ZJUNlict/Mechanics/MOTOR/big wheel/small wheel assembly.SLDASM

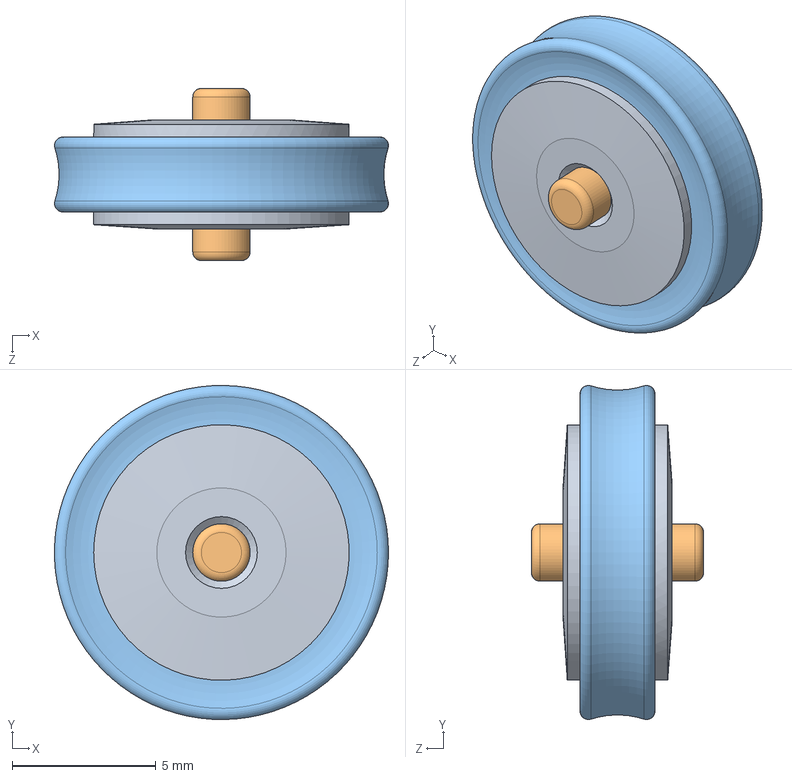
[picture p7: CAD file, 2019-06-18]
MOTOR/big wheel/small wheel assembly.SLDASM
11.6 x 11.6 x 6.00 mm
small wheel
short axle
star_ring
