ZJUNlict/Mechanics/MOTOR/50w_motor_2 assembly.SLDASM

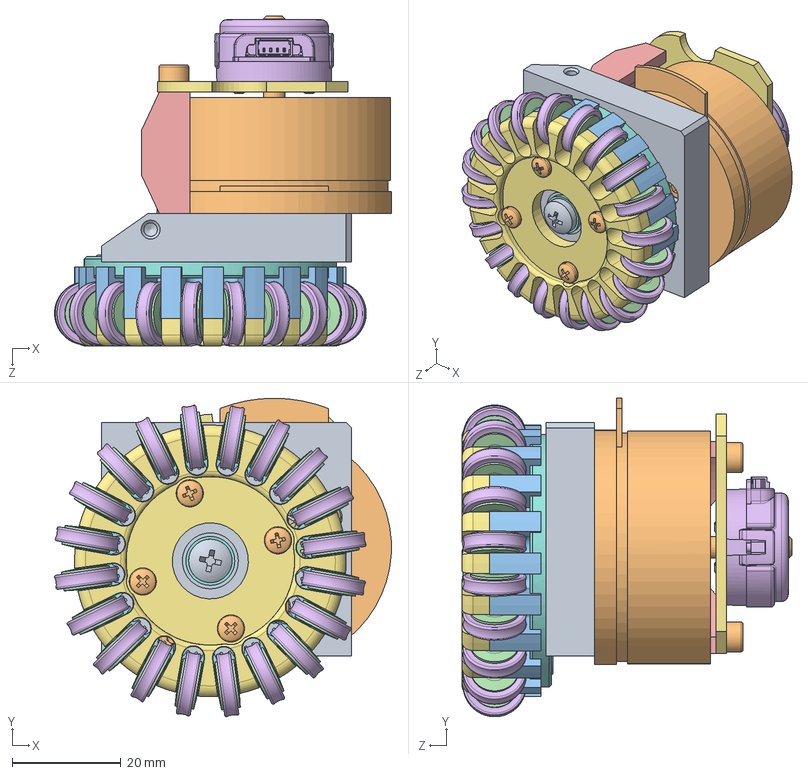
[picture p8: CAD file, 2019-06-18]
MOTOR/50w_motor_2 assembly.SLDASM
62.0 x 58.6 x 60.7 mm
gearbox_2
maxon motor
wheel hub
small wheel x 20
short axle x 20
star_ring x 20
wheel cover
big gear
698ZZ
GB_CROSS_SCREWS_TYPE1 M3X6-6 H TYPE-N x 4
GB_FASTENER_SCREWS_HSHCS M2X6-N x 4
small gear
code holder_1
code cover
code holder_2
GB_FASTENER_WASHER_PWNA 4
GB_CROSS_SCREWS_TYPE1 M4X8-8 H type-N
GB_FASTENER_SCREWS_HSHCS M3X6-N- x 7
