ZJUNlict/Mechanics/KICK SYS/chip shaft assembly.SLDASM

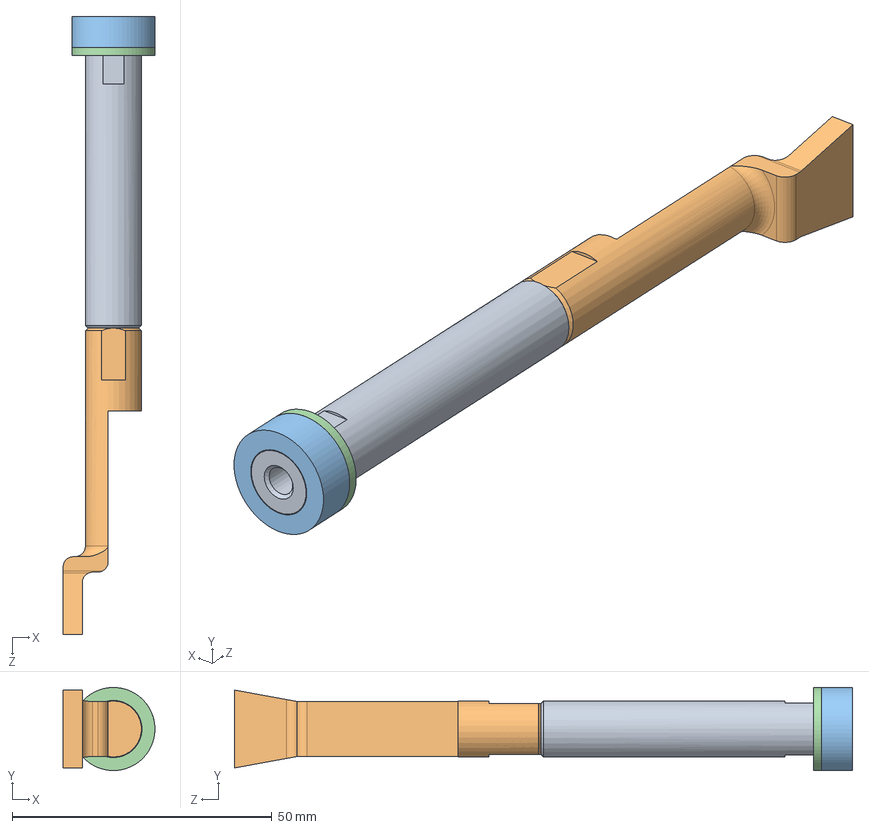
[picture p9: CAD file, 2019-06-18]
KICK SYS/chip shaft assembly.SLDASM
17.7 x 16.0 x 119.0 mm
chip iron core
chip schaft
silicone cushion
buffer block
