ZJUNlict/Mechanics/MOTOR/50w_motor_1 assembly.SLDASM

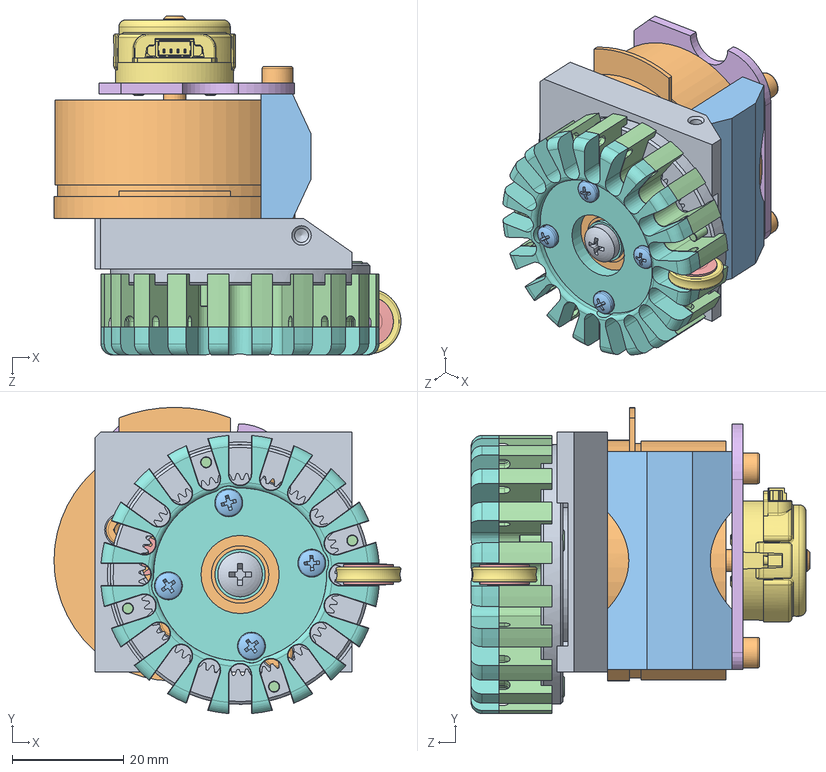
[picture p10: CAD file, 2019-06-18]
MOTOR/50w_motor_1 assembly.SLDASM
62.2 x 54.9 x 60.7 mm
gearbox_1
maxon motor
code holder_1
wheel hub
wheel cover
big gear
698ZZ
GB_CROSS_SCREWS_TYPE1 M3X6-6 H TYPE-N x 4
GB_FASTENER_SCREWS_HSHCS M2X6-N x 4
small gear
code holder_2
code cover
GB_FASTENER_WASHER_PWNA 4
GB_CROSS_SCREWS_TYPE1 M4X8-8 H type-N
GB_FASTENER_SCREWS_HSHCS M3X6-N- x 7
