ZJUNlict/Mechanics/KICK SYS/flat shaft assembly.SLDASM

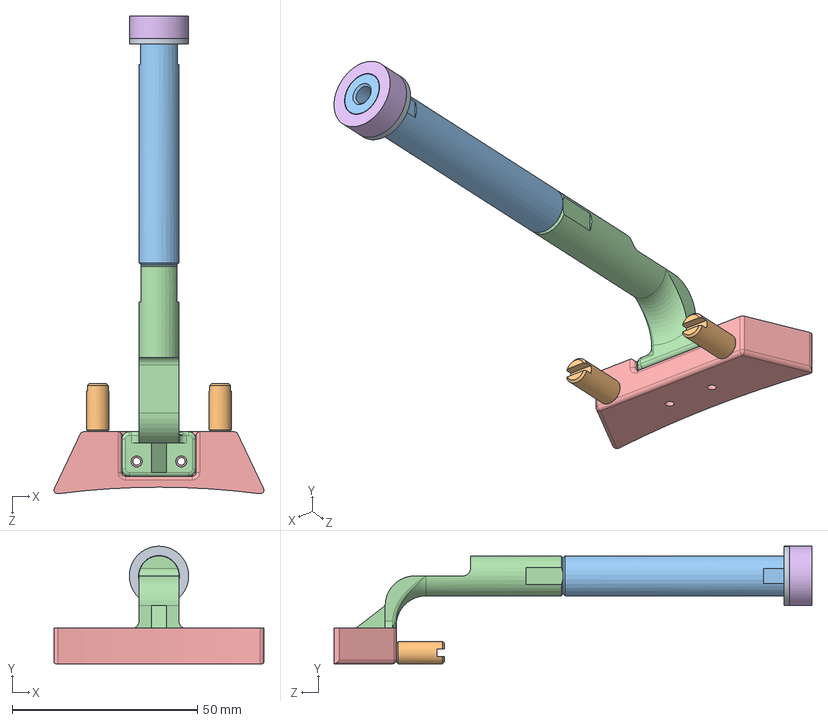
[picture p11: CAD file, 2019-06-18]
KICK SYS/flat shaft assembly.SLDASM
56.6 x 31.7 x 128.7 mm
buffer block
flat guide shaft x 2
flat iron core
flat shaft
flat shove
silicone cushion
