ZJUNlict/Mechanics/BASE/BASE.SLDASM

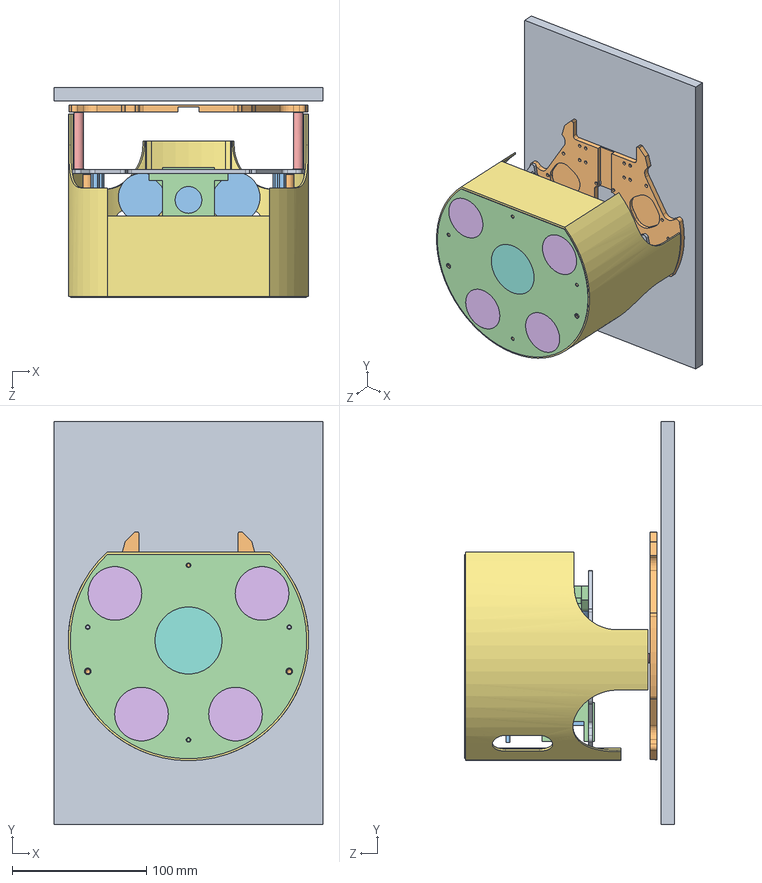
[picture p12: CAD file, 2019-06-18]
BASE/BASE.SLDASM
200.0 x 300.0 x 156.0 mm
baseplate_2018
carpet
circuits
colorcode
downstrut x 2
idcolor x 4
teamcolor
upperplate_2018
upperstrut x 2
battery
batteryholder
