ZJUNlict/Mechanics/MOTOR/big wheel/big wheel assembly.SLDASM

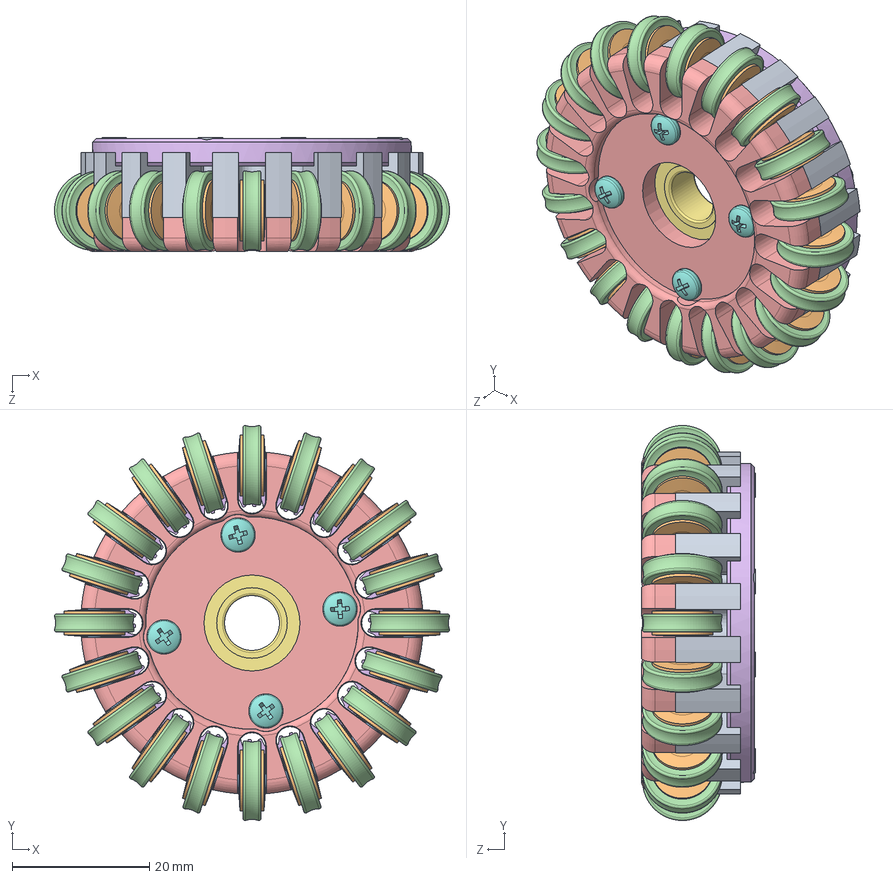
[picture p13: CAD file, 2019-06-18]
MOTOR/big wheel/big wheel assembly.SLDASM
57.6 x 57.6 x 16.7 mm
wheel hub
small wheel x 20
short axle x 20
star_ring x 20
wheel cover
big gear
698ZZ
GB_CROSS_SCREWS_TYPE1 M3X6-6 H TYPE-N x 4
GB_FASTENER_SCREWS_HSHCS M2X6-N x 4
