ZJUNlict/Mechanics/KICK SYS/kick system.SLDASM

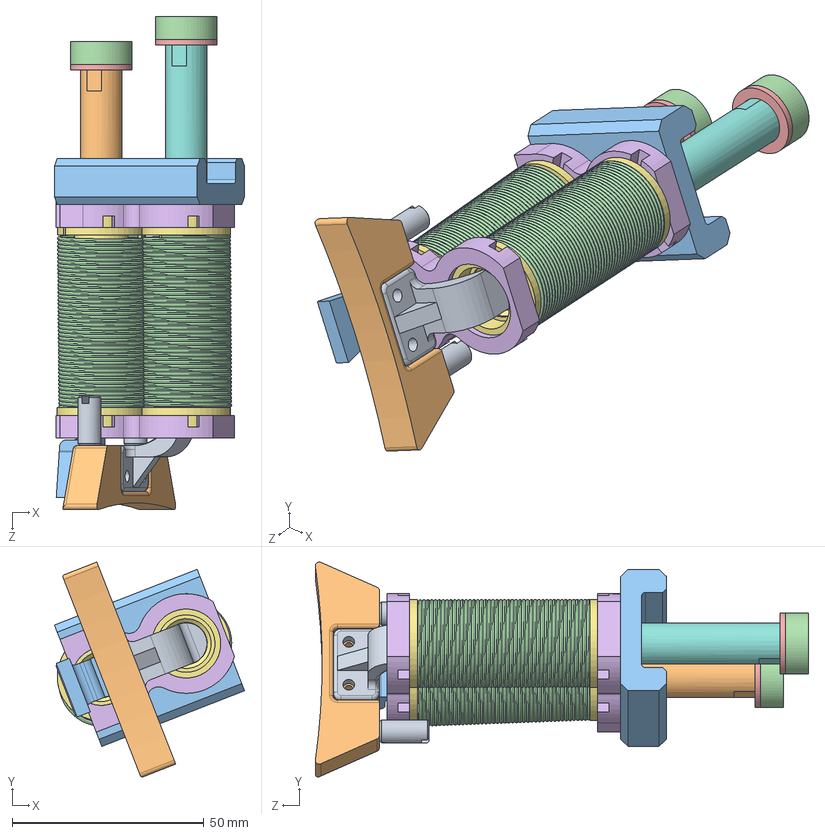
[picture p14: CAD file, 2019-06-18]
KICK SYS/kick system.SLDASM
49.6 x 56.1 x 128.7 mm
chip iron core
chip schaft
silicone cushion x 2
buffer block x 2
coil shelf x 2
flat coil x 2
flat guide shaft x 2
flat iron core
flat shaft
flat shove
limit block
varnished wire x 2
