ZJUNlict/Mechanics/MOUTH/MOUTH_CAN.SLDASM

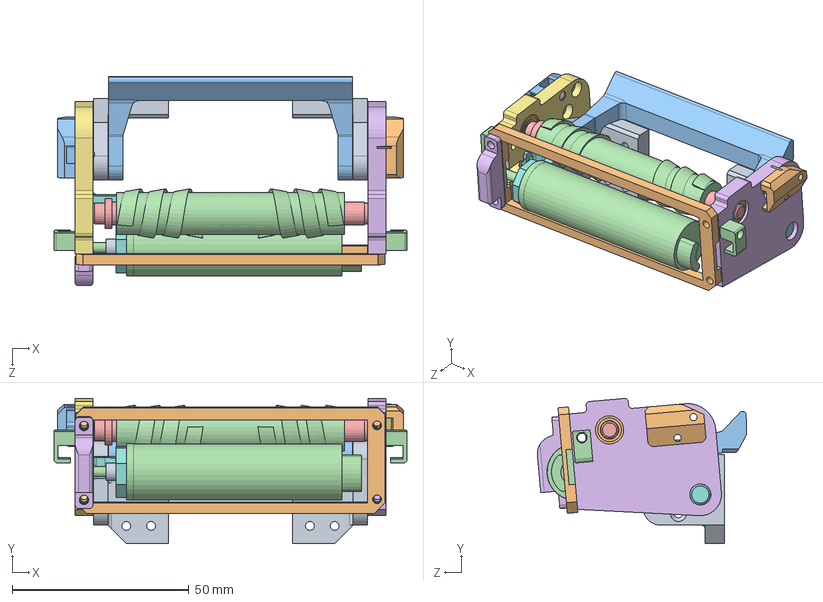
[picture p15: CAD file, 2019-06-18]
MOUTH/MOUTH_CAN.SLDASM
100.0 x 41.1 x 59.3 mm
flat guide block_1
carbon shelf
chip spindle x 2
dribble motor
dribble rod
dribble shelf_1
dribble shelf_2
dribble spindle x 2
flat guide block_2
IR block1
IR block2
IR constraint x 2
IR emitter
IR protector
IR receiver
motor connector
motor sleeve
MR105ZZ x 2
chip sholve_45
silicone tube
