ZJUNlict/Mechanics/MOUTH/MR84ZZ.SLDASM

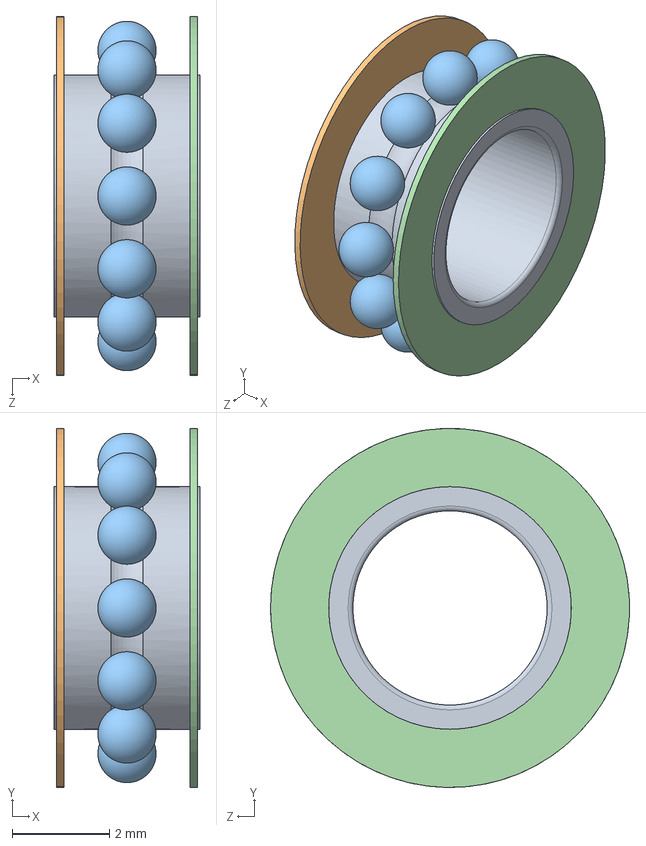
[picture p16: CAD file, 2019-06-18]
MOUTH/MR84ZZ.SLDASM
3.00 x 7.40 x 7.40 mm
_MR84ZZ Inner Ring
_MR84ZZ Shield1
_MR84ZZ Ball x 12
_MR84ZZ Shield2
