ZJUNlict/Mechanics/BASE/carpet.SLDPRT

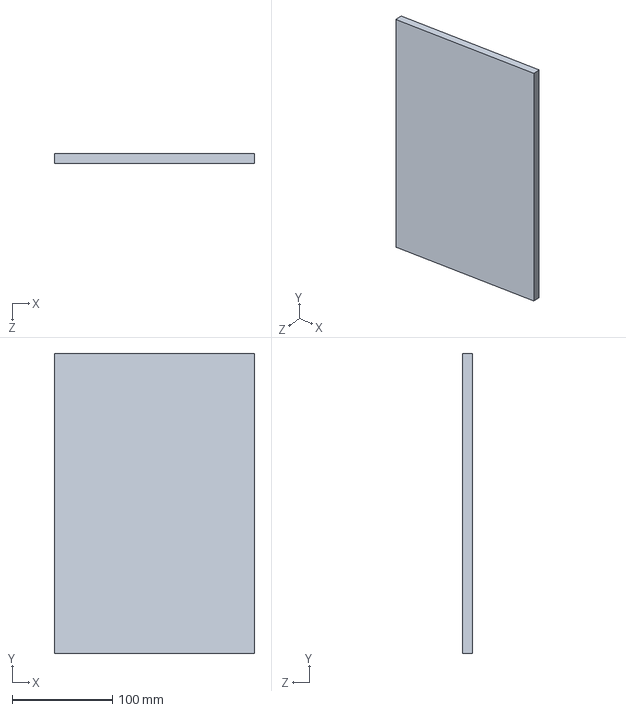
[picture p17: CAD file, 2019-06-19]
BASE/carpet.SLDPRT
200.0 x 300.0 x 10.0 mm
