ZJUNlict/Mechanics/KICK SYS/coil shelf.SLDPRT

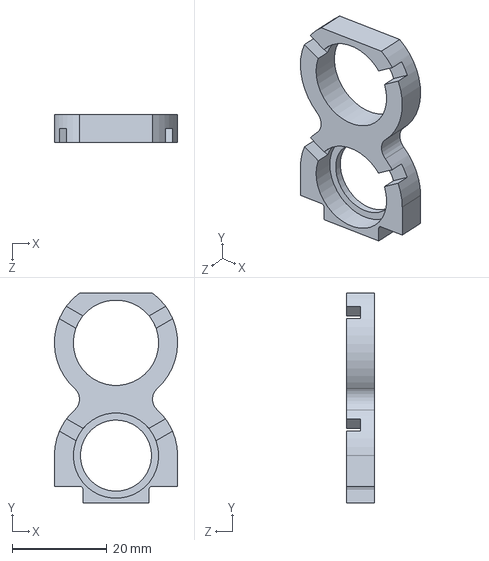
[picture p18: CAD file, 2019-06-18]
KICK SYS/coil shelf.SLDPRT
26.0 x 44.3 x 6.00 mm
