ZJUNlict/Mechanics/MOTOR/maxon motor.SLDPRT

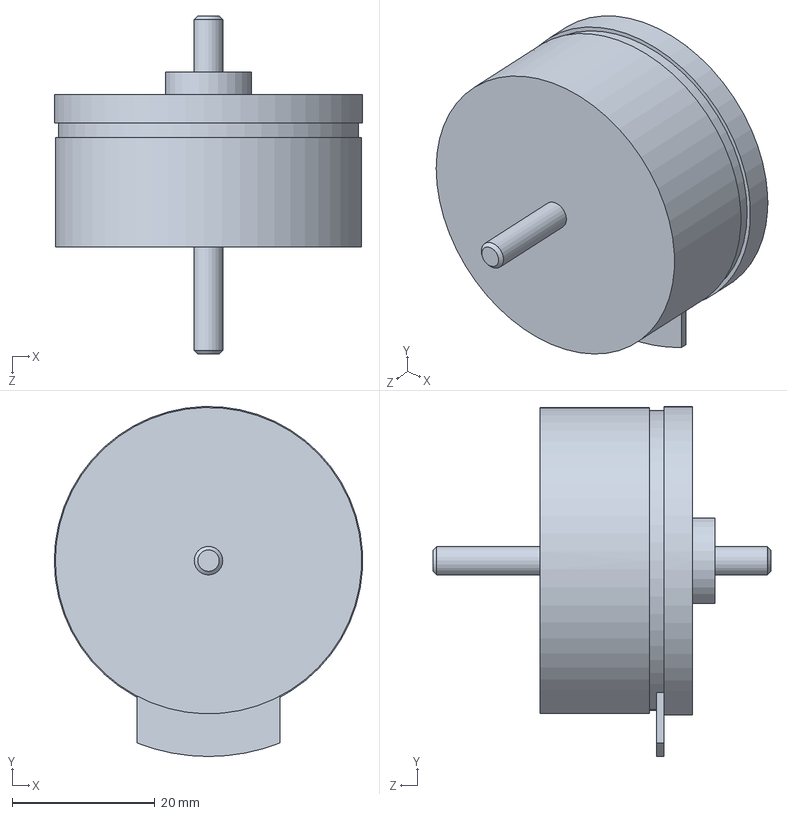
[picture p19: CAD file, 2019-06-18]
MOTOR/maxon motor.SLDPRT
43.2 x 49.0 x 47.3 mm
