ZJUNlict/Mechanics/MOUTH/dribble shelf_1.SLDPRT

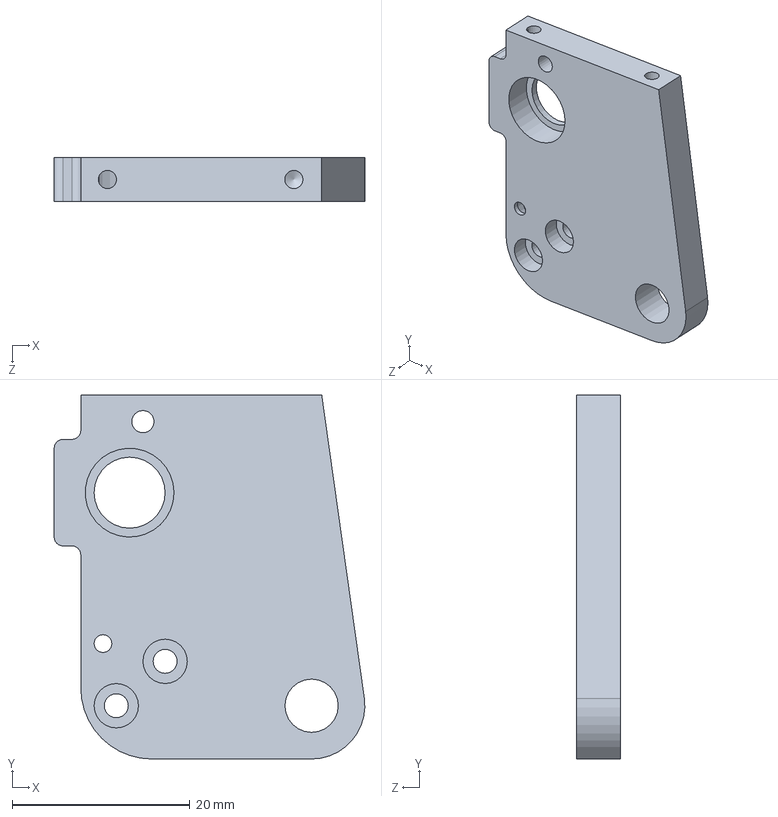
[picture p20: CAD file, 2019-06-18]
MOUTH/dribble shelf_1.SLDPRT
35.0 x 41.0 x 5.00 mm
