ZJUNlict/Mechanics/BASE/battery.SLDPRT

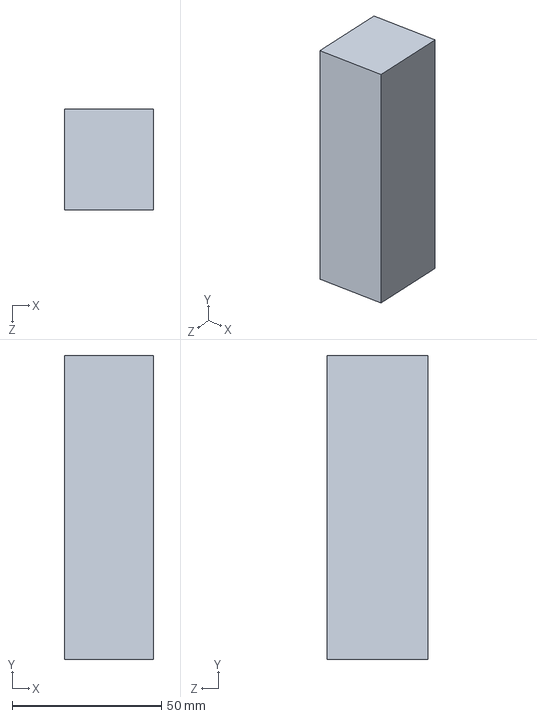
[picture p21: CAD file, 2019-06-18]
BASE/battery.SLDPRT
30.0 x 102.0 x 34.0 mm
