ZJUNlict/Mechanics/KICK SYS/flat guide shaft.SLDPRT

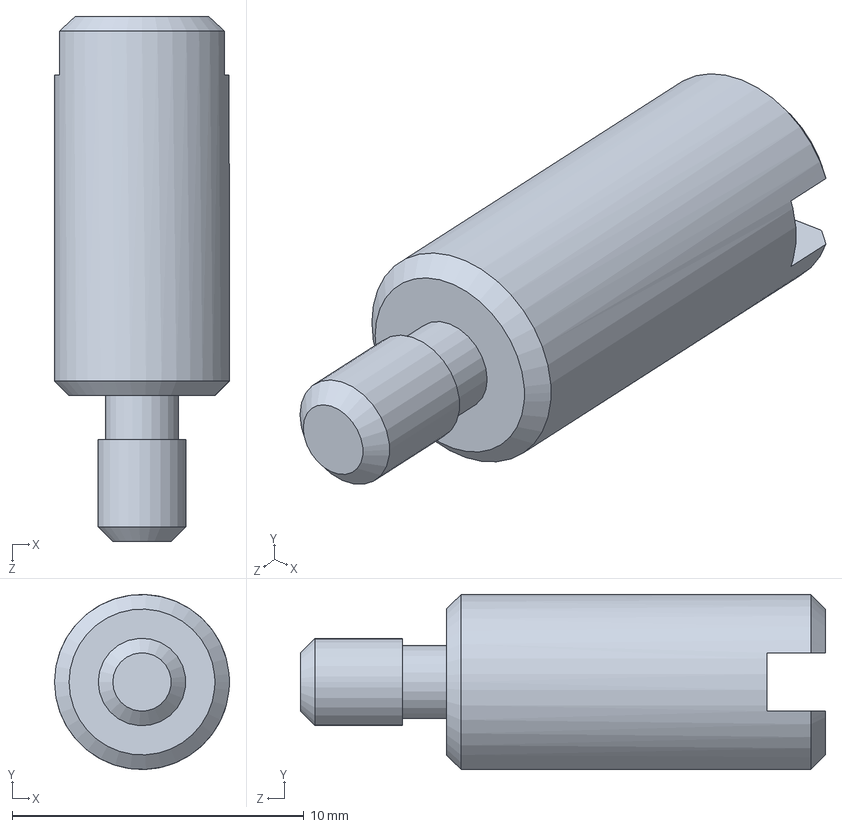
[picture p22: CAD file, 2019-06-18]
KICK SYS/flat guide shaft.SLDPRT
6.00 x 6.00 x 18.0 mm
