ZJUNlict/Mechanics/MOTOR/big wheel/small wheel.SLDPRT

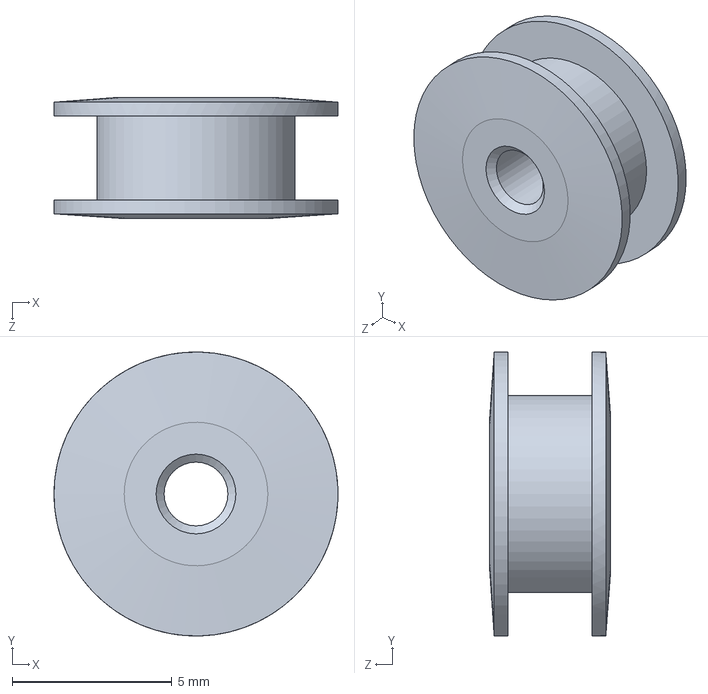
[picture p23: CAD file, 2019-06-18]
MOTOR/big wheel/small wheel.SLDPRT
8.90 x 8.90 x 3.80 mm
