ZJUNlict/Mechanics/MOTOR/gearbox_2.SLDPRT

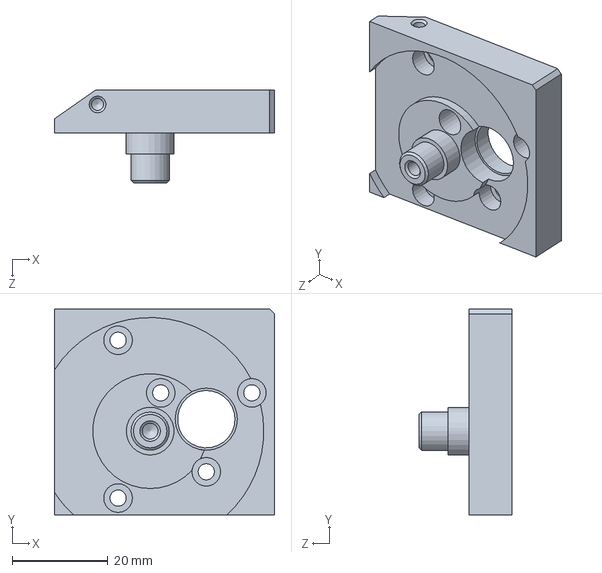
[picture p24: CAD file, 2019-06-18]
MOTOR/gearbox_2.SLDPRT
46.0 x 43.0 x 19.4 mm
