ZJUNlict/Mechanics/BASE/upperplate_2018.SLDPRT

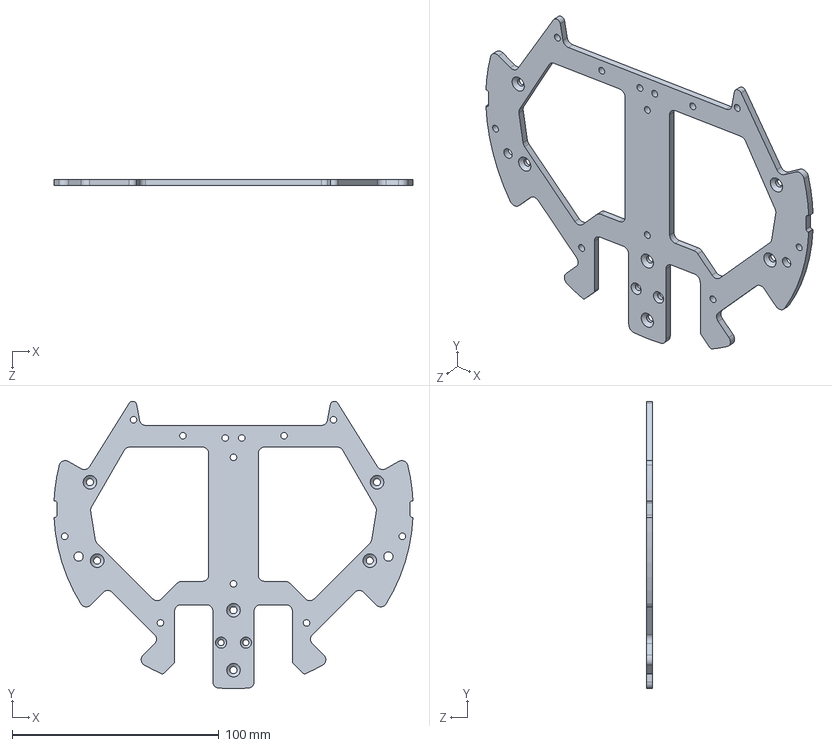
[picture p25: CAD file, 2019-06-18]
BASE/upperplate_2018.SLDPRT
173.8 x 139.2 x 3.00 mm
