ZJUNlict/Mechanics/KICK SYS/flat coil.SLDPRT

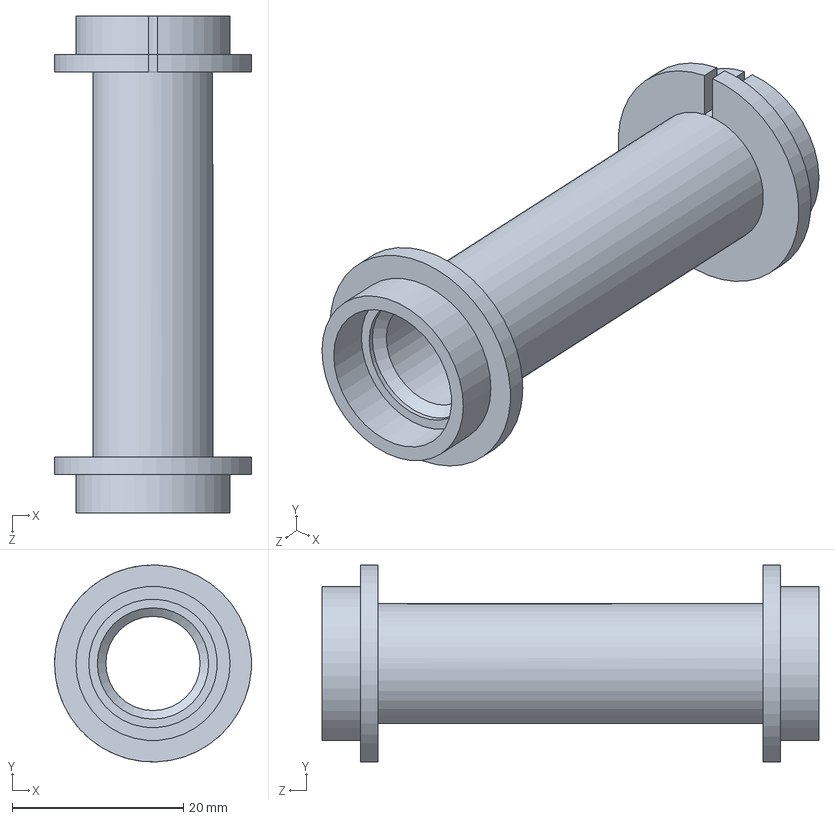
[picture p26: CAD file, 2019-06-18]
KICK SYS/flat coil.SLDPRT
23.0 x 23.0 x 58.0 mm
