ZJUNlict/Mechanics/MOTOR/big wheel/wheel hub.SLDPRT

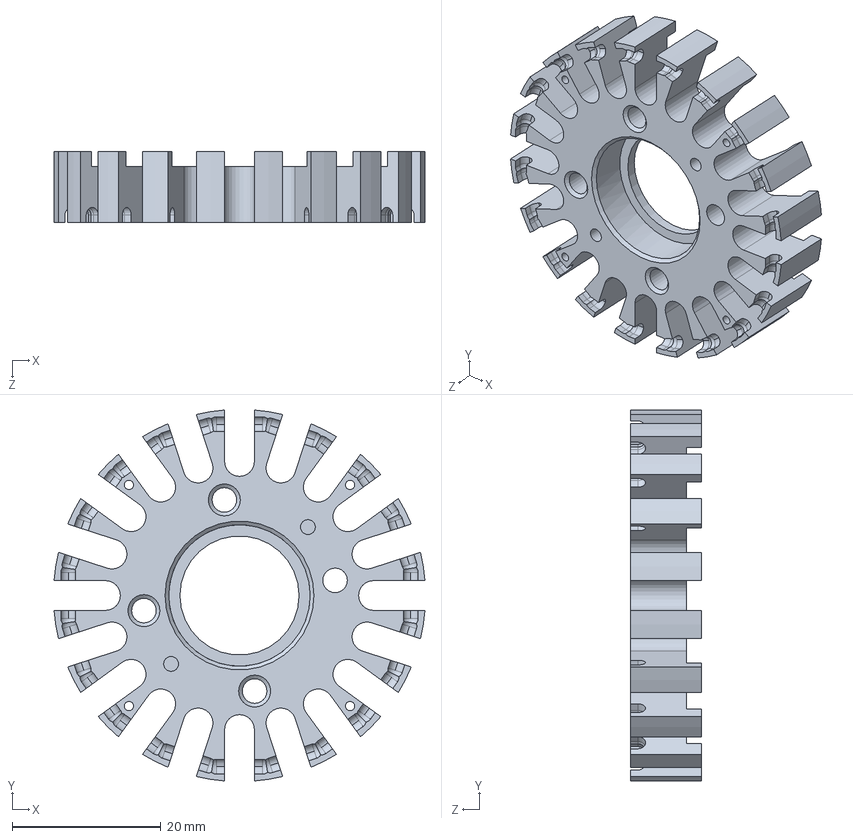
[picture p27: CAD file, 2019-06-18]
MOTOR/big wheel/wheel hub.SLDPRT
49.8 x 49.8 x 9.50 mm
