ZJUNlict/Mechanics/MOUTH/m0.5rodgearrod.SLDPRT

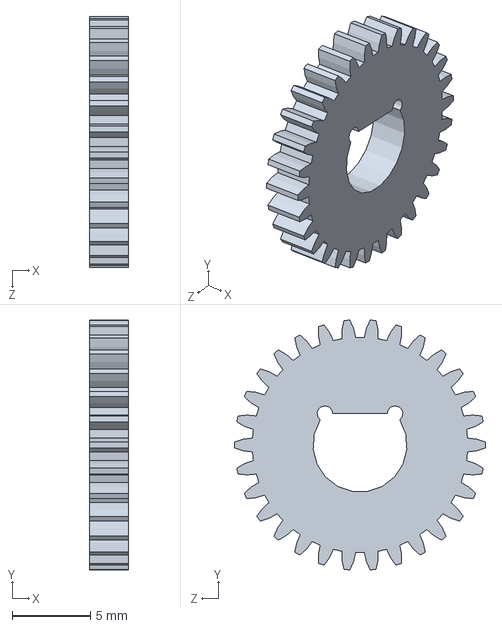
[picture p28: CAD file, 2019-06-18]
MOUTH/m0.5rodgearrod.SLDPRT
2.50 x 15.9 x 16.0 mm
