ZJUNlict/Mechanics/BASE/circuits.SLDPRT

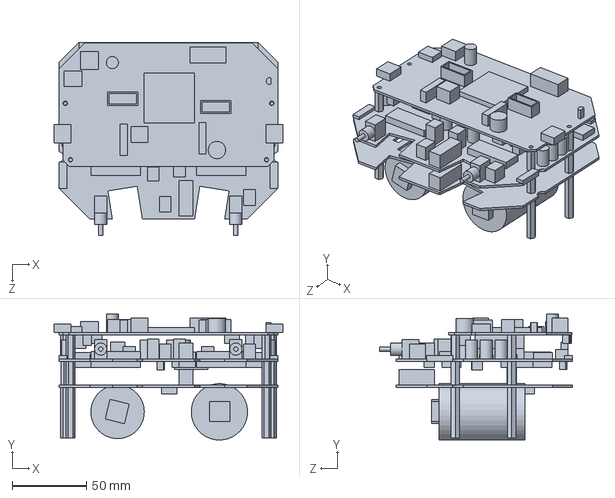
[picture p29: CAD file, 2019-06-18]
BASE/circuits.SLDPRT
154.2 x 84.8 x 129.9 mm
