ZJUNlict/Mechanics/MOTOR/big wheel/small gear.SLDPRT

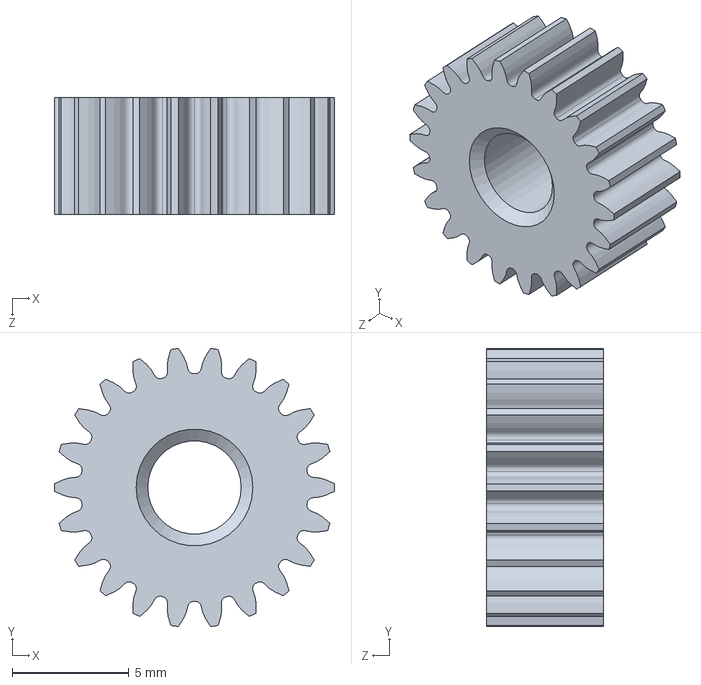
[picture p30: CAD file, 2019-06-18]
MOTOR/big wheel/small gear.SLDPRT
12.0 x 11.9 x 5.00 mm
