ZJUNlict/Mechanics/BASE/colorcode.SLDPRT

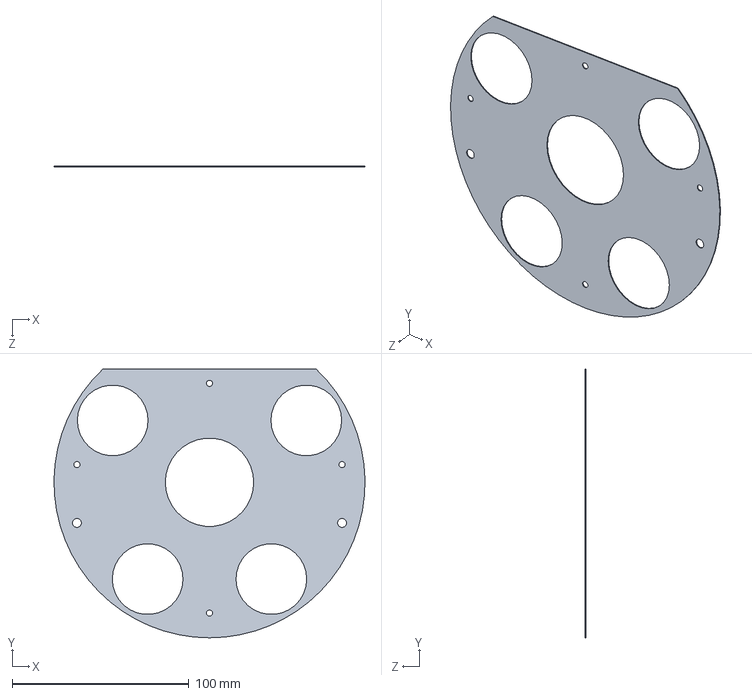
[picture p31: CAD file, 2019-06-18]
BASE/colorcode.SLDPRT
176.0 x 152.0 x 0.5 mm
