ZJUNlict/Mechanics/KICK SYS/silicone cushion.SLDPRT

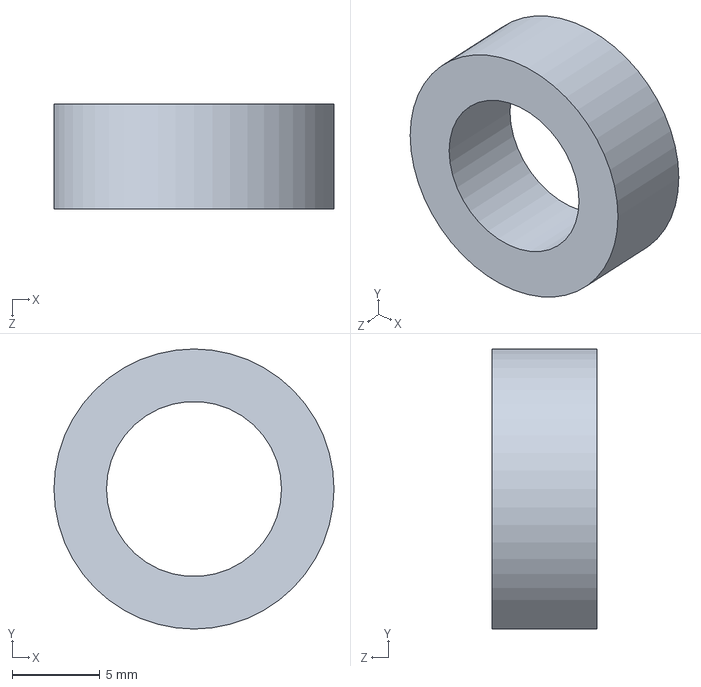
[picture p32: CAD file, 2019-06-18]
KICK SYS/silicone cushion.SLDPRT
16.0 x 16.0 x 6.00 mm
