ZJUNlict/Mechanics/MOTOR/big wheel/big gear.SLDPRT

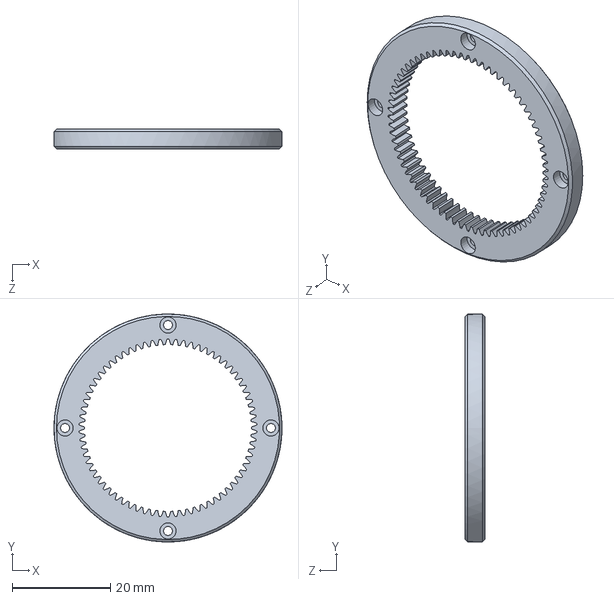
[picture p33: CAD file, 2019-06-18]
MOTOR/big wheel/big gear.SLDPRT
46.5 x 46.5 x 4.00 mm
