ZJUNlict/Mechanics/MOTOR/code holder_1.SLDPRT

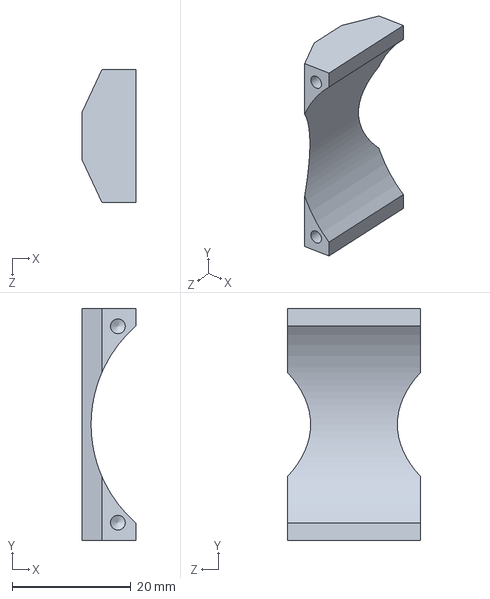
[picture p34: CAD file, 2019-06-18]
MOTOR/code holder_1.SLDPRT
9.00 x 39.0 x 22.3 mm
