ZJUNlict/Mechanics/MOUTH/silicone tube.SLDPRT

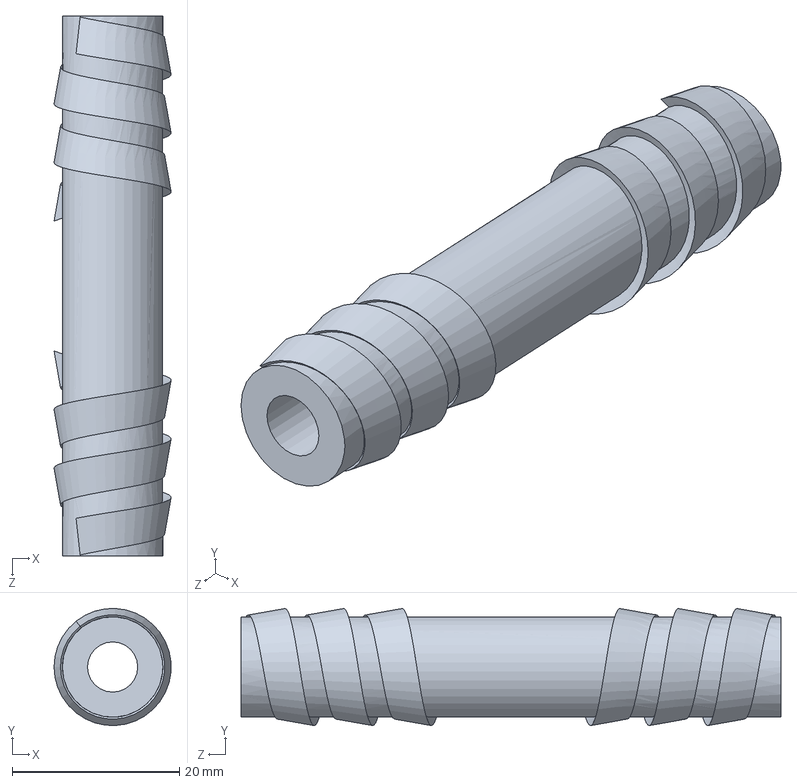
[picture p35: CAD file, 2019-06-18]
MOUTH/silicone tube.SLDPRT
14.0 x 14.0 x 64.5 mm
