ZJUNlict/Mechanics/BASE/downstrut.SLDPRT

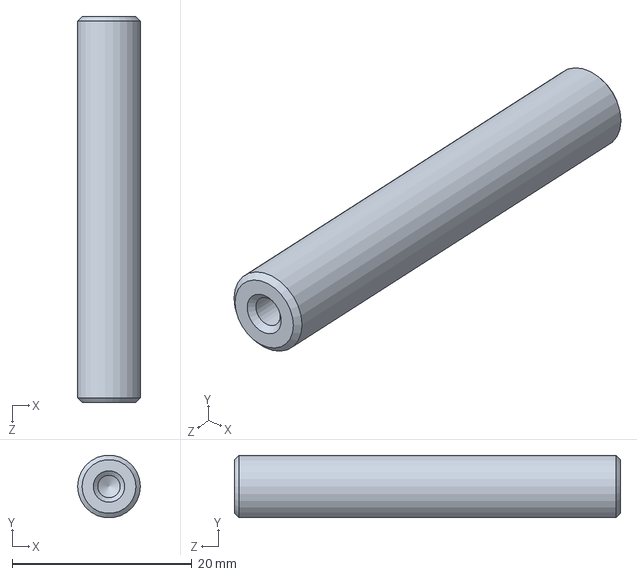
[picture p36: CAD file, 2019-06-18]
BASE/downstrut.SLDPRT
7.00 x 6.95 x 43.0 mm
