ZJUNlict/Mechanics/MOTOR/big wheel/698ZZ.SLDPRT

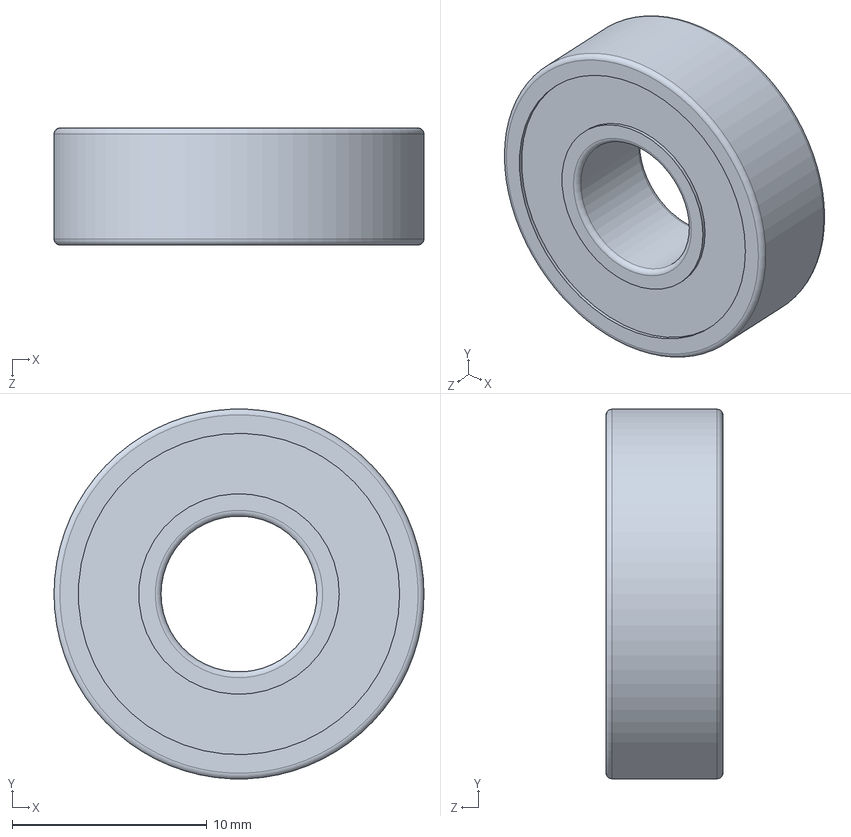
[picture p37: CAD file, 2019-06-18]
MOTOR/big wheel/698ZZ.SLDPRT
19.0 x 19.0 x 6.00 mm
