ZJUNlict/Mechanics/MOTOR/code cover.SLDPRT

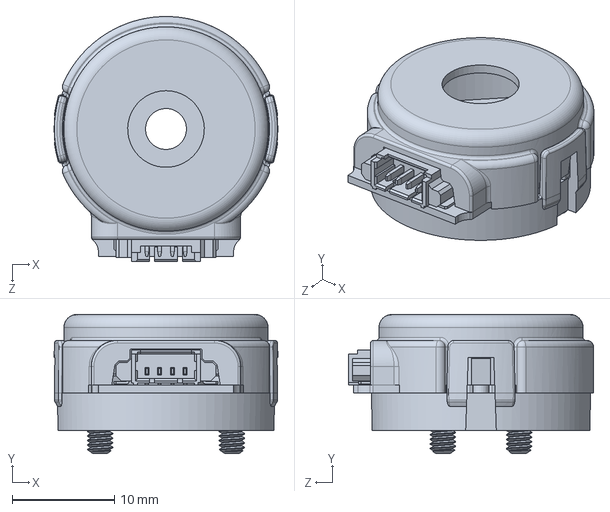
[picture p38: CAD file, 2019-06-18]
MOTOR/code cover.SLDPRT
21.9 x 13.6 x 24.0 mm
