ZJUNlict/Mechanics/BASE/batteryholder.SLDPRT

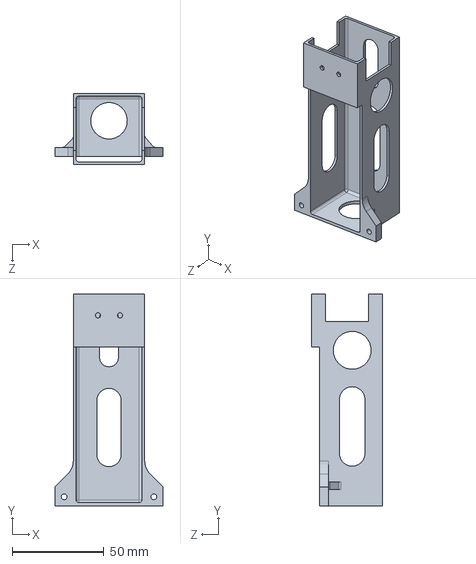
[picture p39: CAD file, 2019-06-18]
BASE/batteryholder.SLDPRT
59.0 x 115.8 x 39.0 mm
