ZJUNlict/Mechanics/KICK SYS/flat shaft.SLDPRT

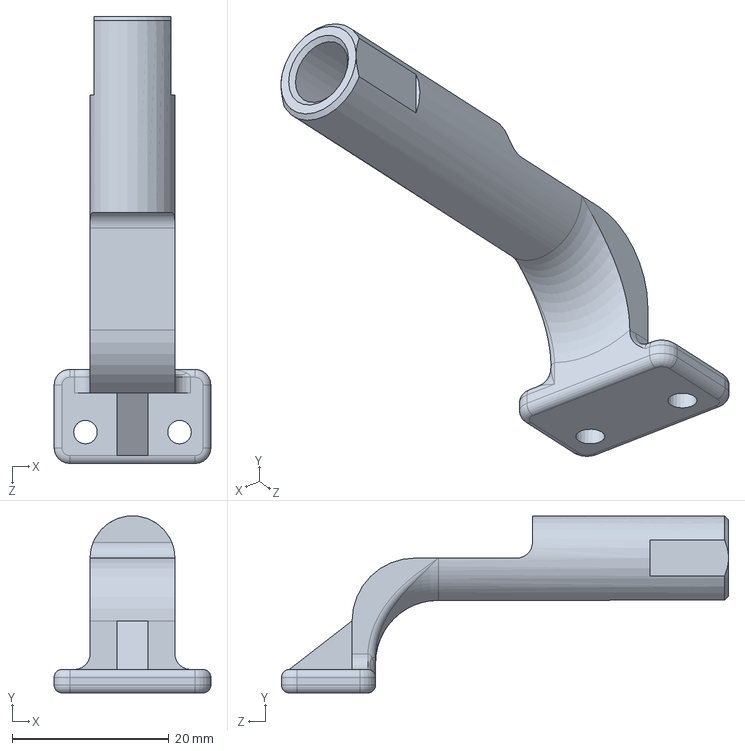
[picture p40: CAD file, 2019-06-18]
KICK SYS/flat shaft.SLDPRT
20.0 x 22.6 x 57.0 mm
