ZJUNlict/Mechanics/MOTOR/big wheel/short axle.SLDPRT

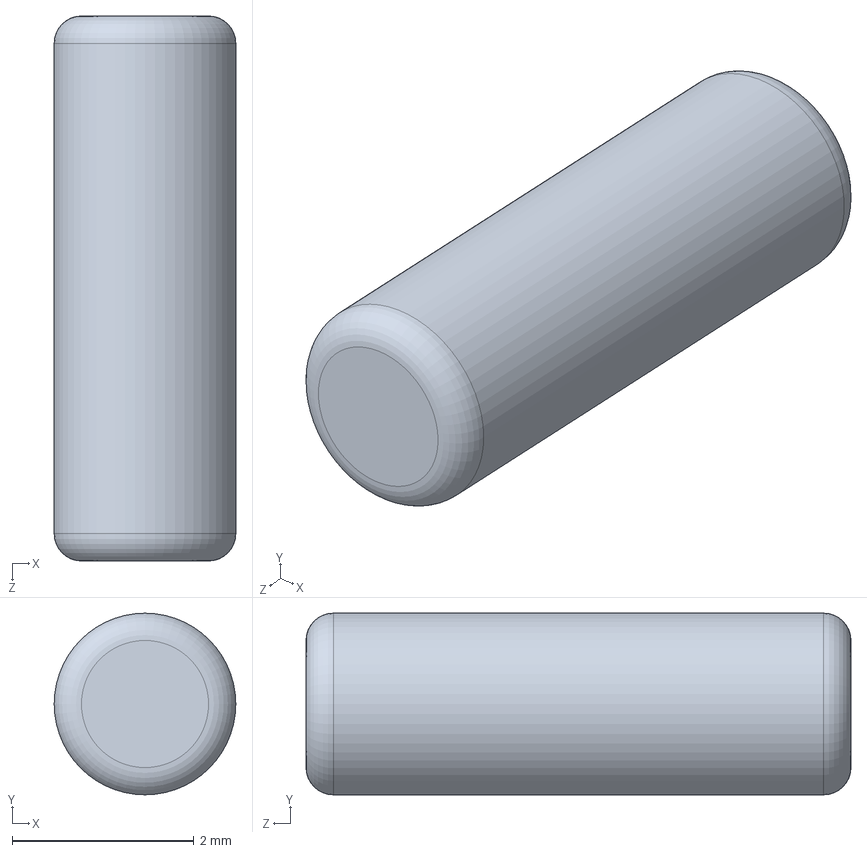
[picture p41: CAD file, 2019-06-18]
MOTOR/big wheel/short axle.SLDPRT
2.00 x 2.00 x 6.00 mm
