ZJUNlict/Mechanics/MOTOR/code holder_2.SLDPRT

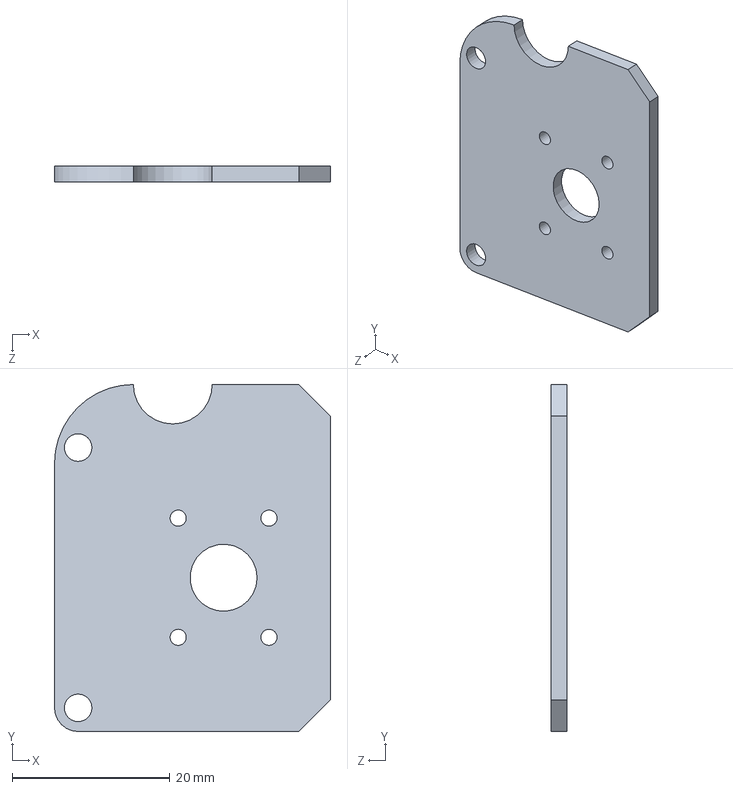
[picture p42: CAD file, 2019-06-18]
MOTOR/code holder_2.SLDPRT
35.0 x 44.0 x 2.00 mm
