ZJUNlict/Mechanics/MOUTH/MR105ZZ.SLDPRT

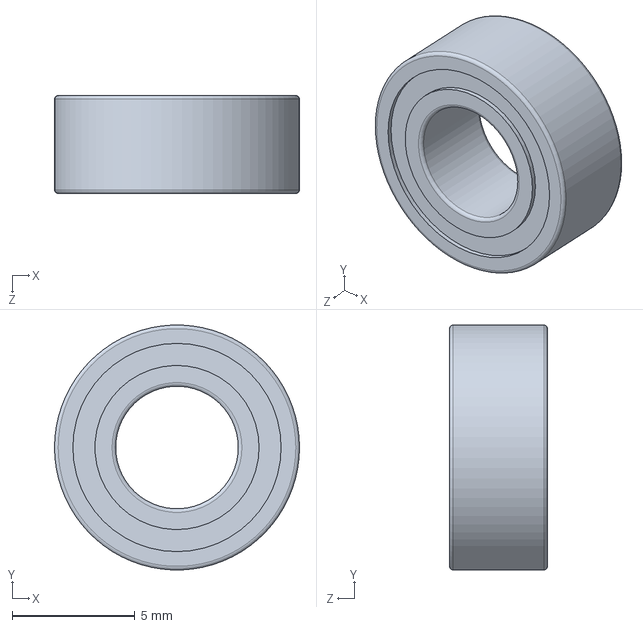
[picture p43: CAD file, 2019-06-18]
MOUTH/MR105ZZ.SLDPRT
10.0 x 9.99 x 4.00 mm
