ZJUNlict/Mechanics/BASE/idcolor.SLDPRT

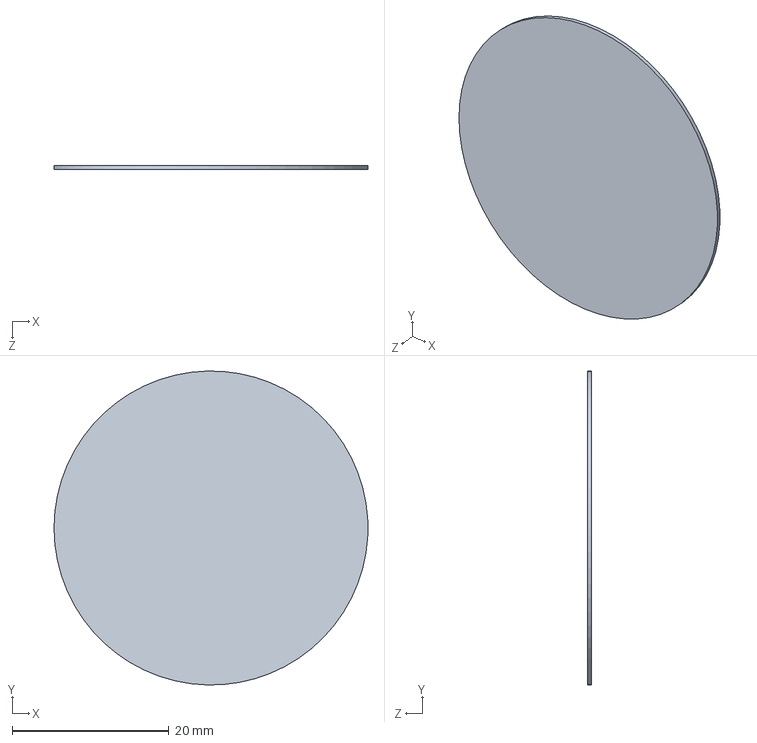
[picture p44: CAD file, 2019-06-18]
BASE/idcolor.SLDPRT
40.0 x 40.0 x 0.5 mm
