ZJUNlict/Mechanics/MOTOR/big wheel/star_ring.SLDPRT

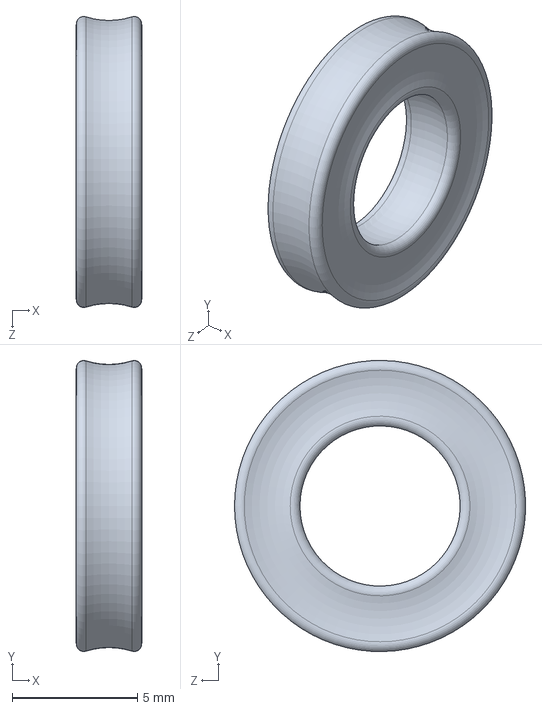
[picture p45: CAD file, 2019-06-18]
MOTOR/big wheel/star_ring.SLDPRT
2.62 x 11.6 x 11.6 mm
