ZJUNlict/Mechanics/MOUTH/dribble spindle.SLDPRT

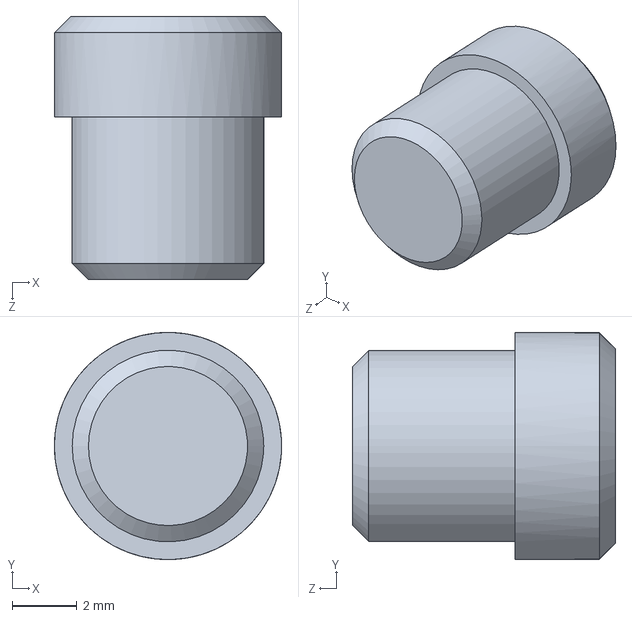
[picture p46: CAD file, 2019-06-18]
MOUTH/dribble spindle.SLDPRT
7.00 x 7.00 x 8.10 mm
