ZJUNlict/Mechanics/BASE/baseplate_2018.SLDPRT

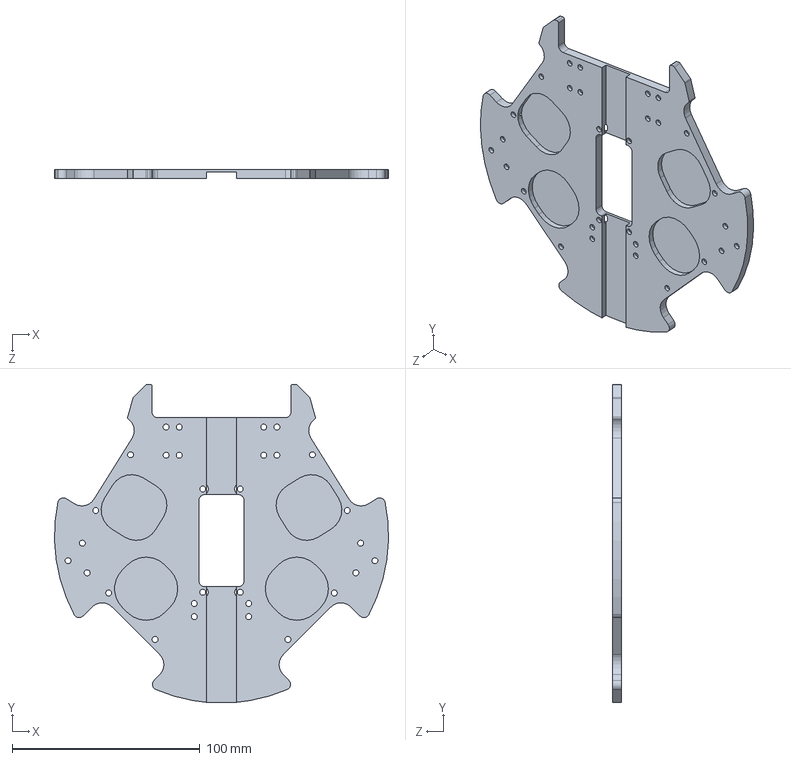
[picture p47: CAD file, 2019-06-18]
BASE/baseplate_2018.SLDPRT
177.9 x 169.6 x 5.00 mm
