ZJUNlict/Mechanics/KICK SYS/chip schaft.SLDPRT

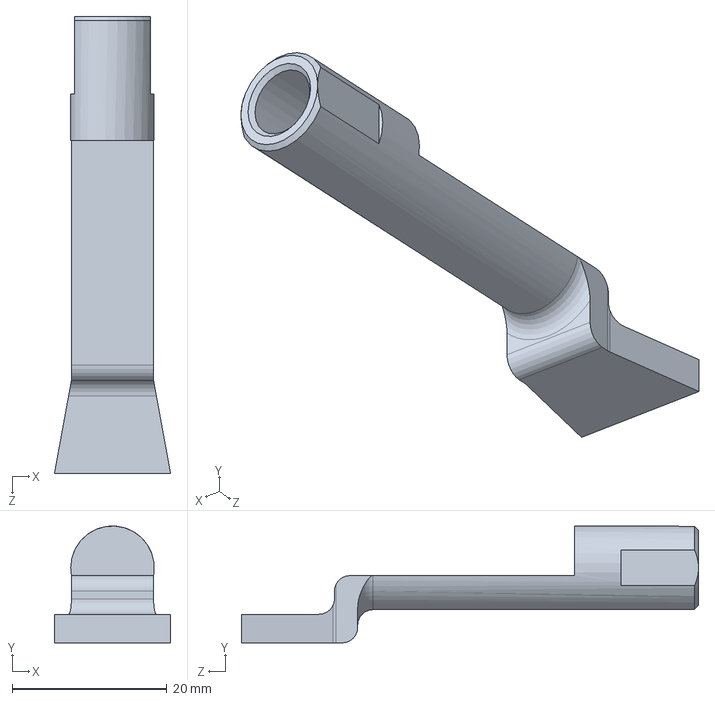
[picture p48: CAD file, 2019-06-18]
KICK SYS/chip schaft.SLDPRT
15.0 x 15.1 x 59.0 mm
