ZJUNlict/Mechanics/MOTOR/big wheel/wheel cover.SLDPRT

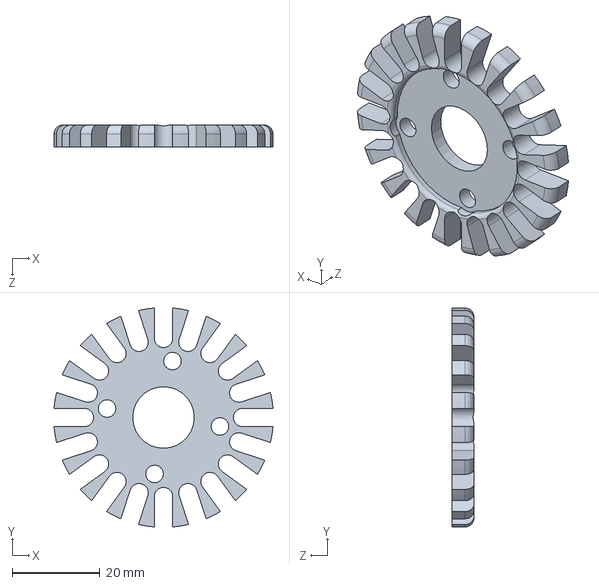
[picture p49: CAD file, 2019-06-18]
MOTOR/big wheel/wheel cover.SLDPRT
49.8 x 49.8 x 5.00 mm
