ZJUNlict/Mechanics/MOUTH/chip sholve_45.SLDPRT

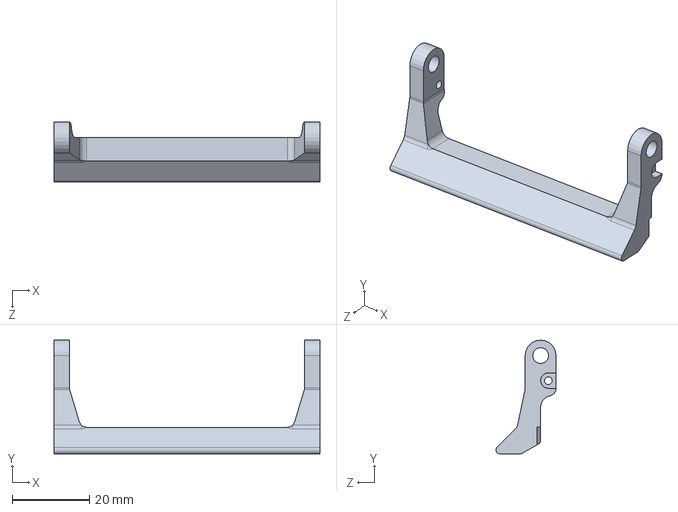
[picture p50: CAD file, 2019-06-18]
MOUTH/chip sholve_45.SLDPRT
69.0 x 29.5 x 15.6 mm
