ZJUNlict/Mechanics/KICK SYS/flat shove.SLDPRT

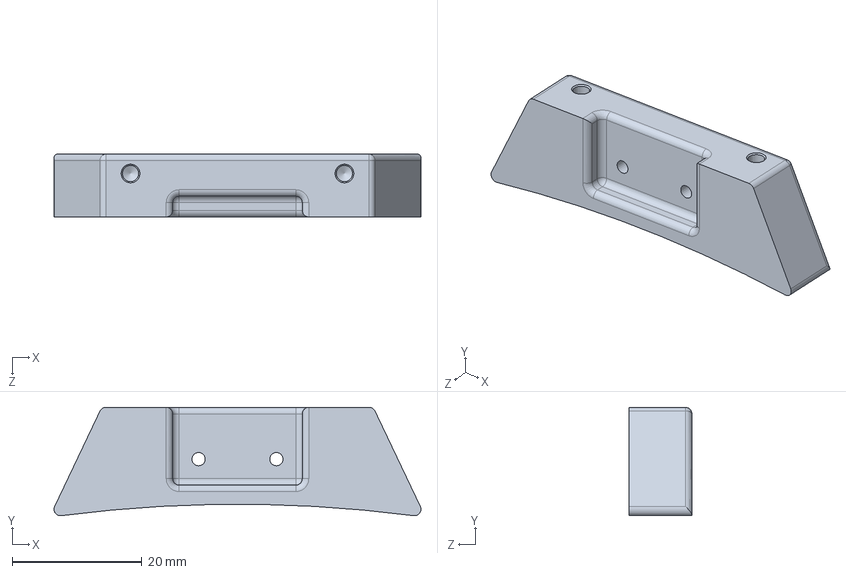
[picture p51: CAD file, 2019-06-18]
KICK SYS/flat shove.SLDPRT
56.6 x 16.7 x 9.70 mm
