ZJUNlict/Mechanics/MOUTH/IR emitter.SLDPRT

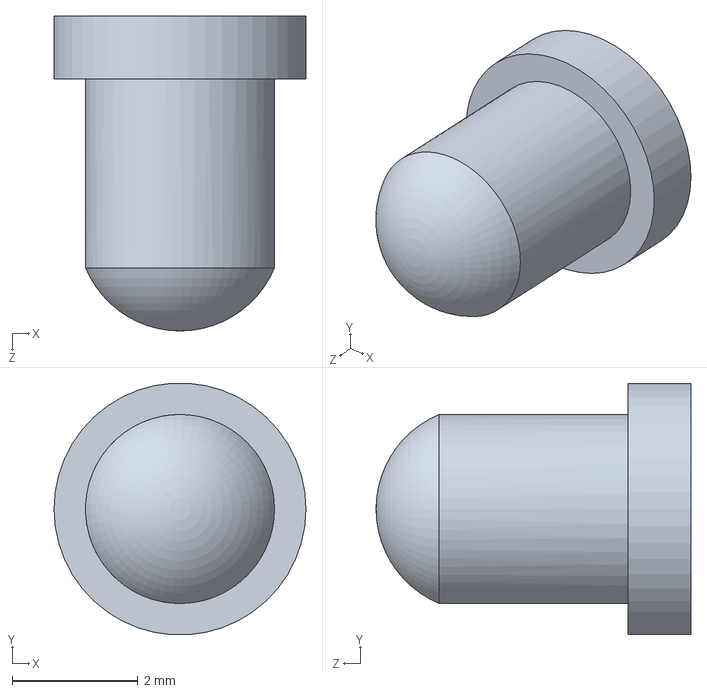
[picture p52: CAD file, 2019-06-18]
MOUTH/IR emitter.SLDPRT
4.00 x 3.99 x 5.00 mm
