ZJUNlict/Mechanics/BASE/shell_2017.SLDPRT

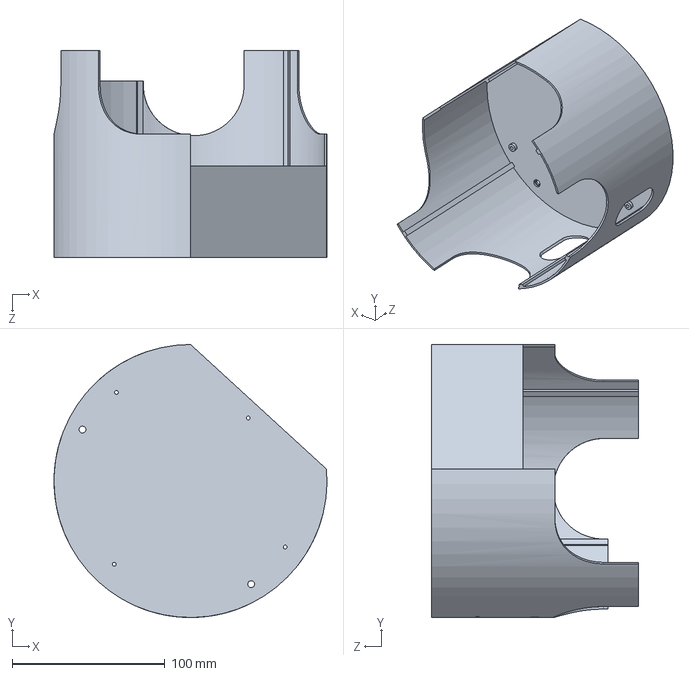
[picture p53: CAD file, 2019-06-18]
BASE/shell_2017.SLDPRT
179.0 x 179.0 x 136.0 mm
