ZJUNlict/Mechanics/MOUTH/carbon shelf.SLDPRT

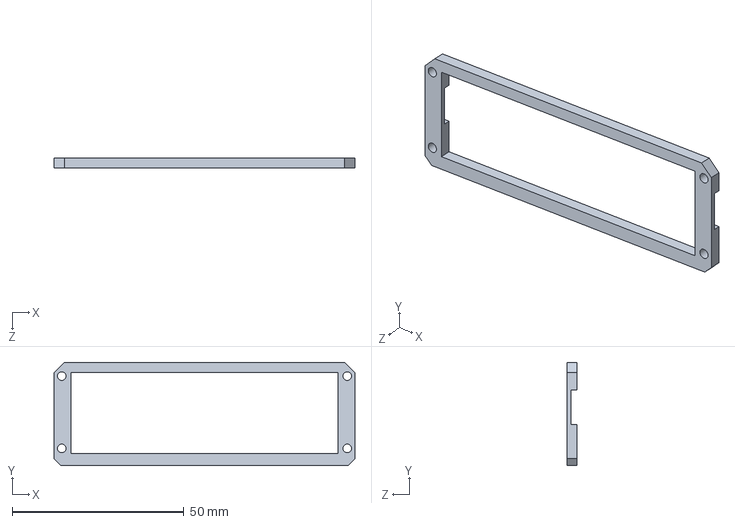
[picture p54: CAD file, 2019-06-18]
MOUTH/carbon shelf.SLDPRT
87.5 x 30.0 x 3.00 mm
