ZJUNlict/Mechanics/BASE/teamcolor.SLDPRT

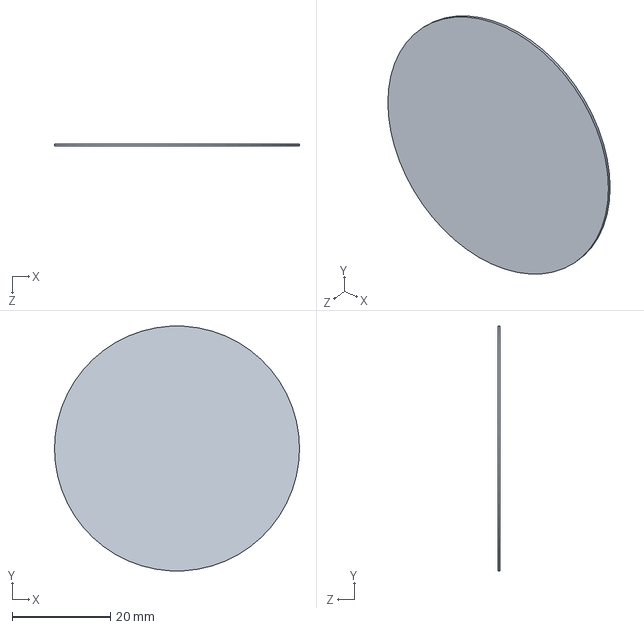
[picture p55: CAD file, 2019-06-18]
BASE/teamcolor.SLDPRT
50.0 x 49.9 x 0.5 mm
