ZJUNlict/Mechanics/KICK SYS/varnished wire.SLDPRT

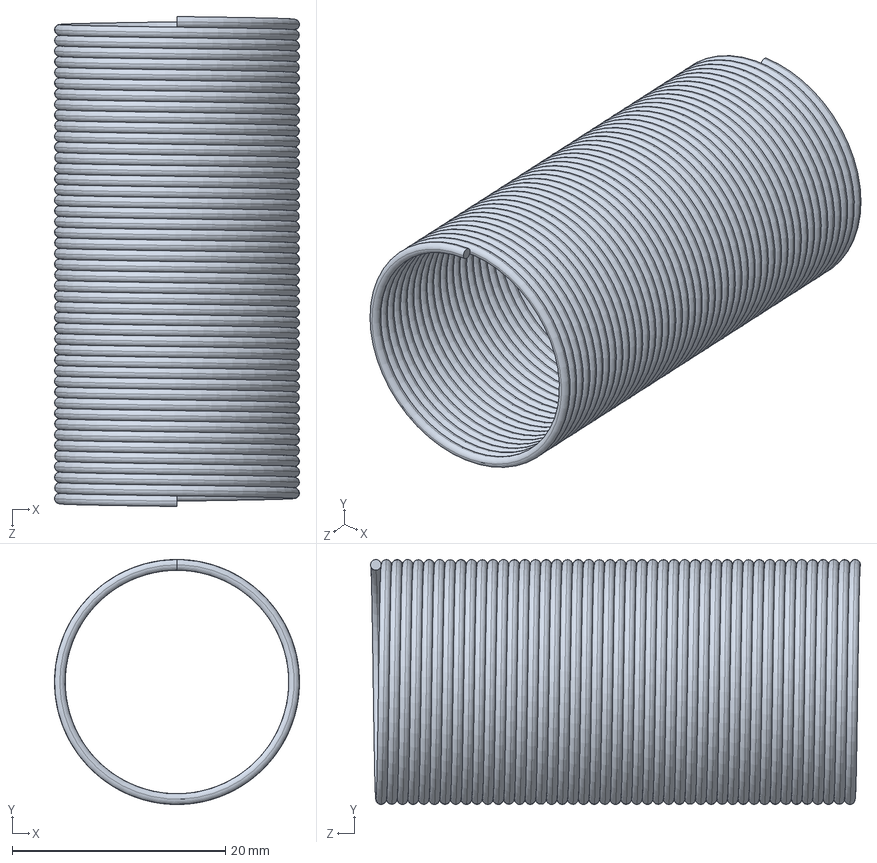
[picture p56: CAD file, 2019-06-18]
KICK SYS/varnished wire.SLDPRT
23.0 x 23.0 x 46.0 mm
