ZJUNlict/Mechanics/MOUTH/flat guide block_2.SLDPRT

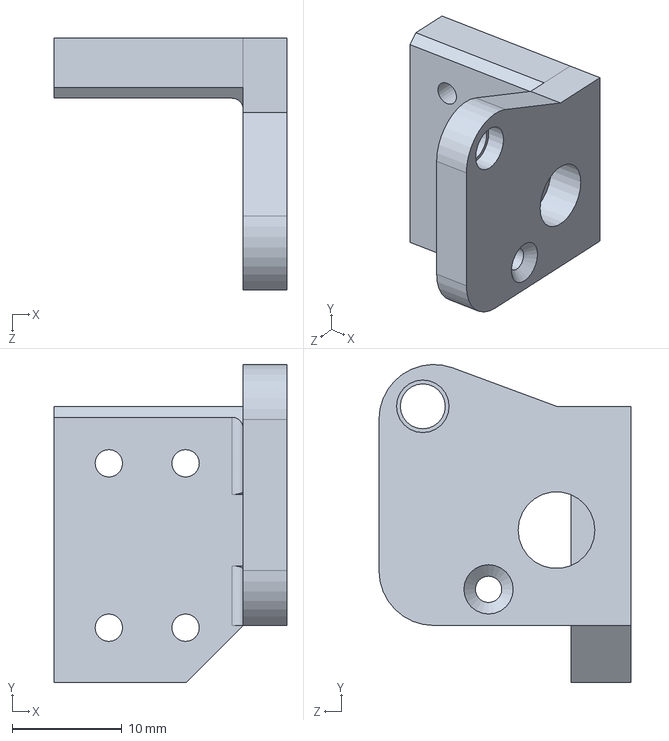
[picture p57: CAD file, 2019-06-18]
MOUTH/flat guide block_2.SLDPRT
21.2 x 29.0 x 23.0 mm
