ZJUNlict/Mechanics/BASE/upperstrut.SLDPRT

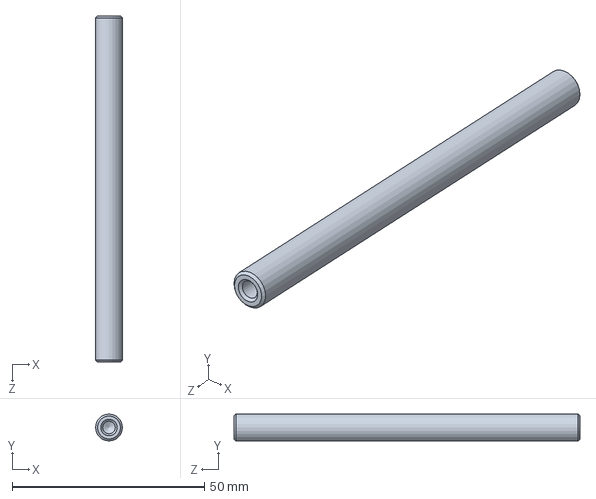
[picture p58: CAD file, 2019-06-18]
BASE/upperstrut.SLDPRT
7.00 x 7.00 x 90.0 mm
