ZJUNlict/Mechanics/KICK SYS/buffer block.SLDPRT

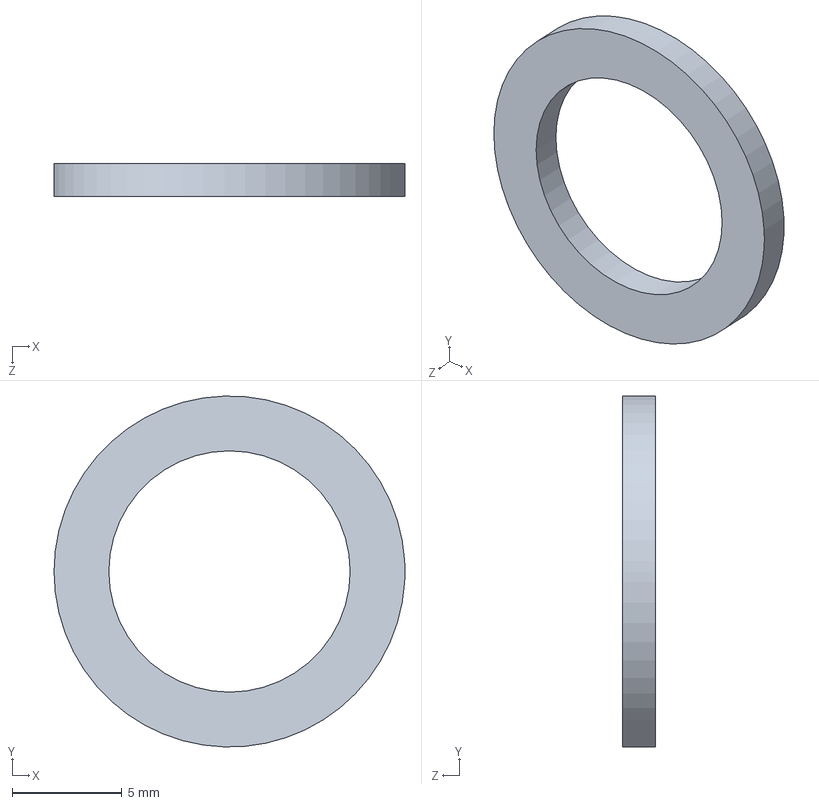
[picture p59: CAD file, 2019-06-18]
KICK SYS/buffer block.SLDPRT
16.0 x 16.0 x 1.50 mm
