ZJUNlict/Mechanics/MOUTH/IR block2.SLDPRT

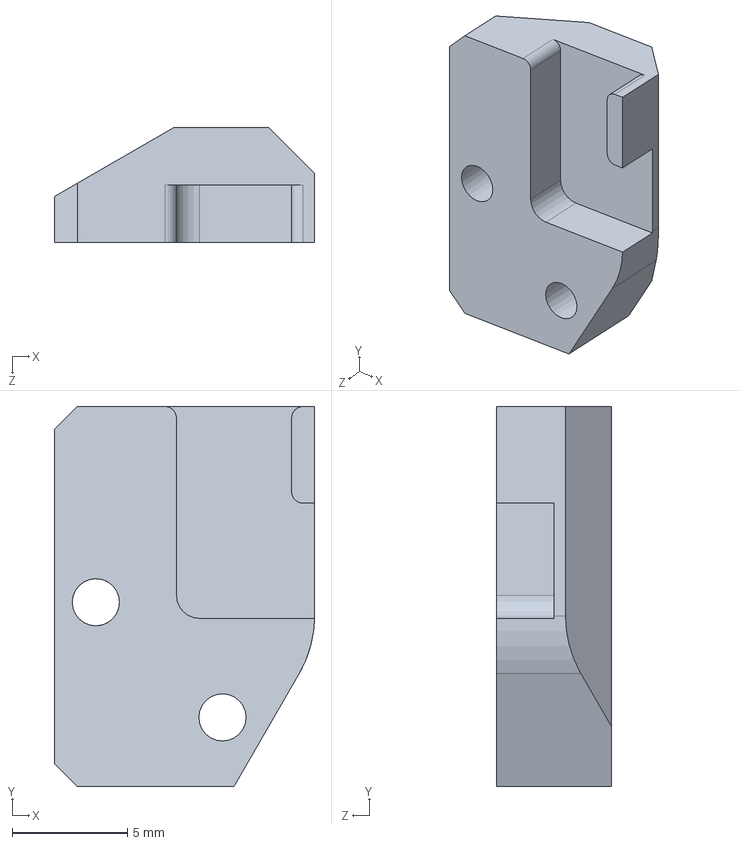
[picture p60: CAD file, 2019-06-18]
MOUTH/IR block2.SLDPRT
11.3 x 16.5 x 5.00 mm
