ZJUNlict/Mechanics/BASE/golfball.SLDPRT

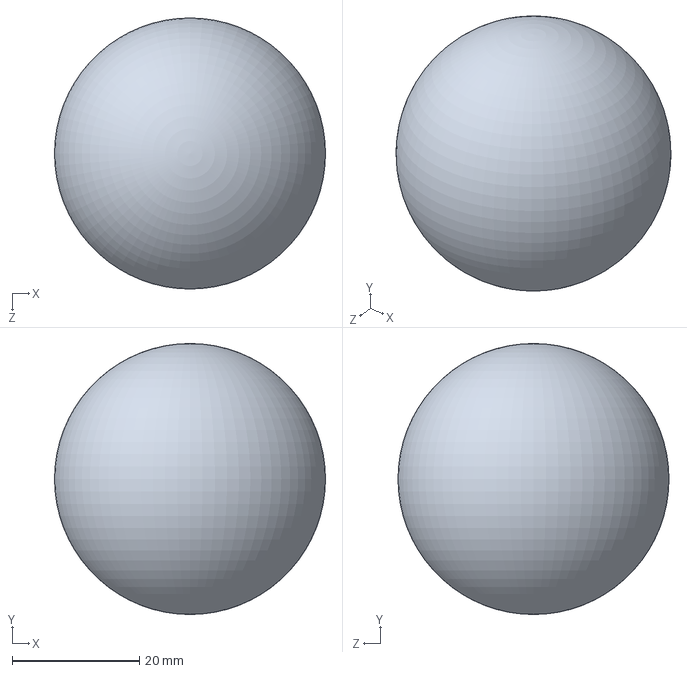
[picture p61: CAD file, 2019-06-18]
BASE/golfball.SLDPRT
42.6 x 42.6 x 42.6 mm
