ZJUNlict/Mechanics/KICK SYS/chip iron core.SLDPRT

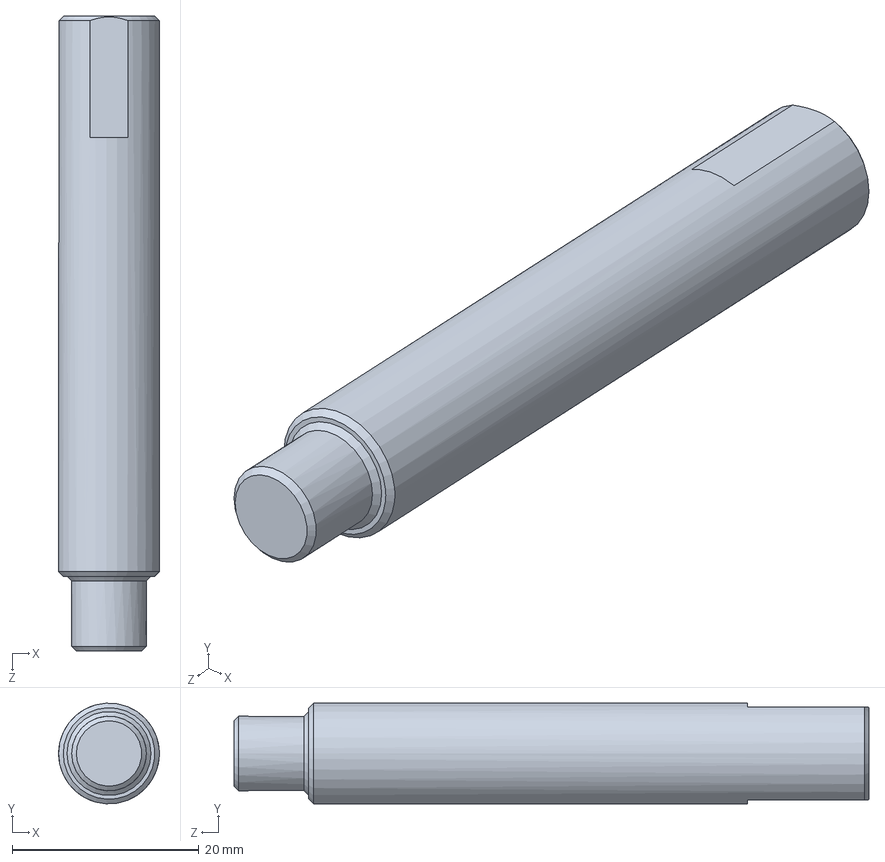
[picture p62: CAD file, 2019-06-18]
KICK SYS/chip iron core.SLDPRT
10.8 x 10.8 x 68.0 mm
