ZJUNlict/Mechanics/MOUTH/motor connector.SLDPRT

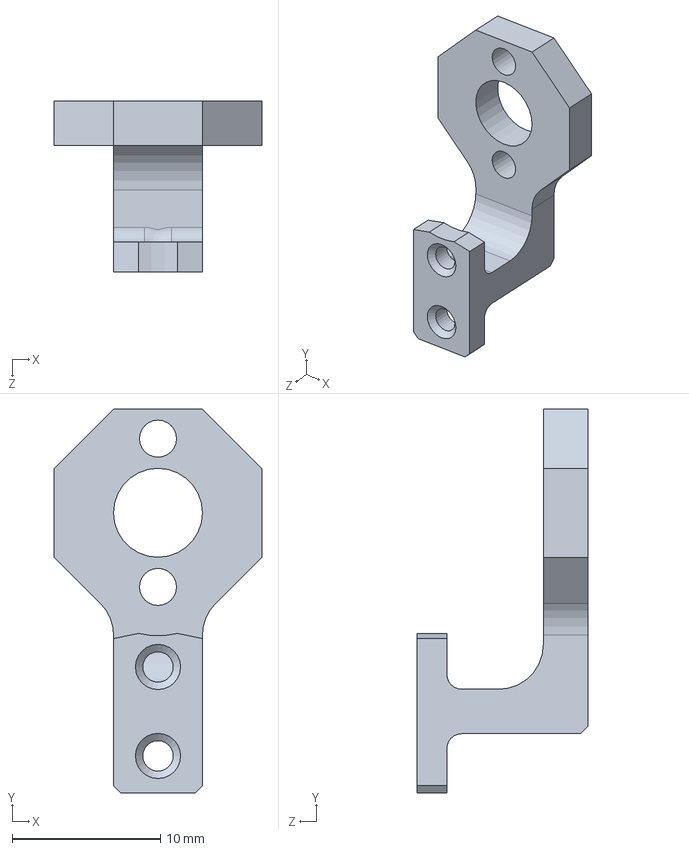
[picture p63: CAD file, 2019-06-18]
MOUTH/motor connector.SLDPRT
14.0 x 25.9 x 11.5 mm
