ZJUNlict/Mechanics/KICK SYS/flat iron core.SLDPRT

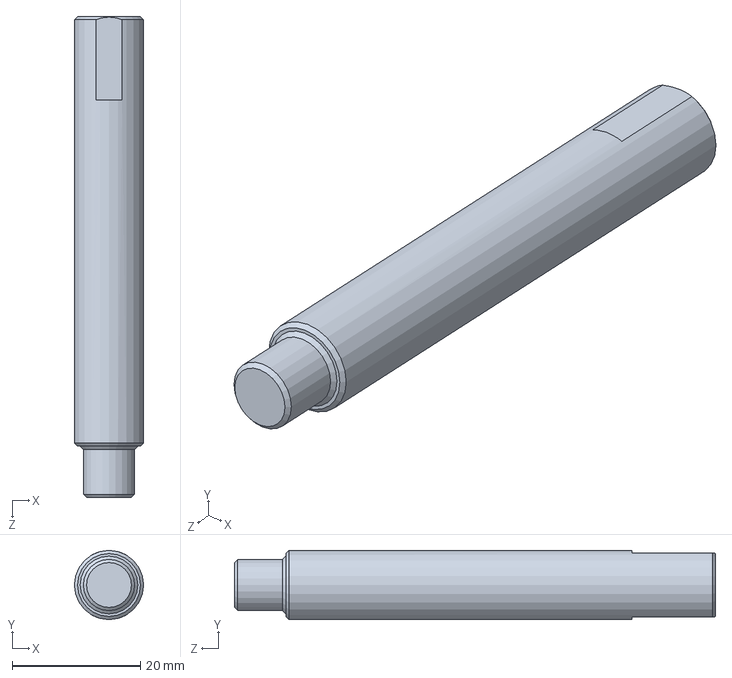
[picture p64: CAD file, 2019-06-18]
KICK SYS/flat iron core.SLDPRT
10.8 x 10.8 x 75.0 mm
