ZJUNlict/Mechanics/MOUTH/chip spindle.SLDPRT

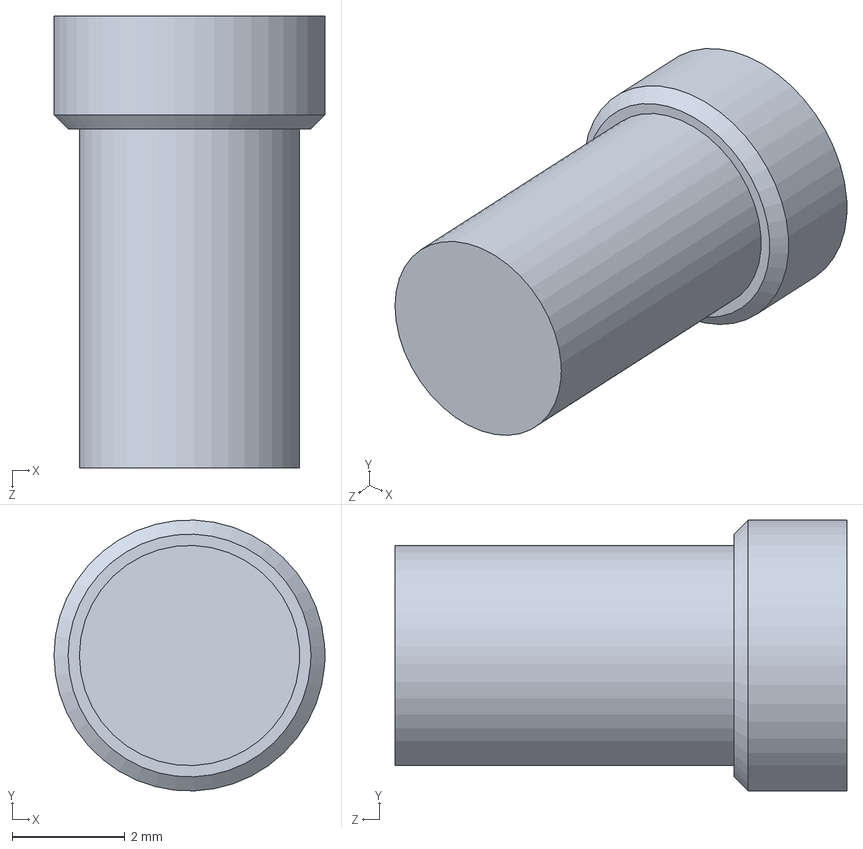
[picture p65: CAD file, 2019-06-18]
MOUTH/chip spindle.SLDPRT
4.80 x 4.80 x 8.00 mm
