ZJUNlict/Mechanics/KICK SYS/limit block.SLDPRT

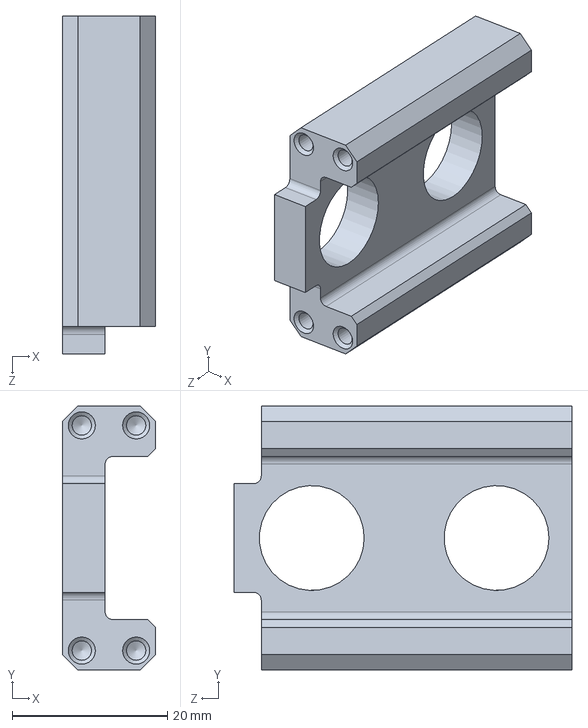
[picture p66: CAD file, 2019-06-18]
KICK SYS/limit block.SLDPRT
12.0 x 34.0 x 43.5 mm
