ZJUNlict/Mechanics/MOUTH/IR receiver.SLDPRT

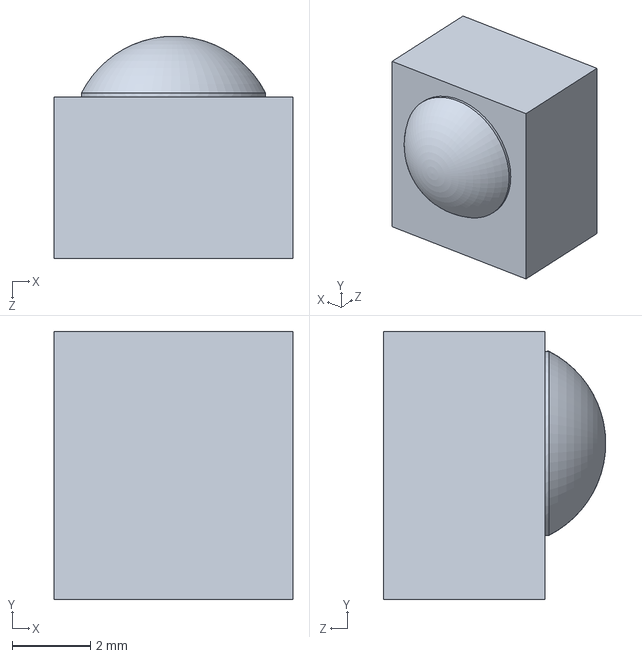
[picture p67: CAD file, 2019-06-18]
MOUTH/IR receiver.SLDPRT
6.08 x 6.83 x 5.67 mm
