ZJUNlict/Mechanics/MOUTH/IR protector.SLDPRT

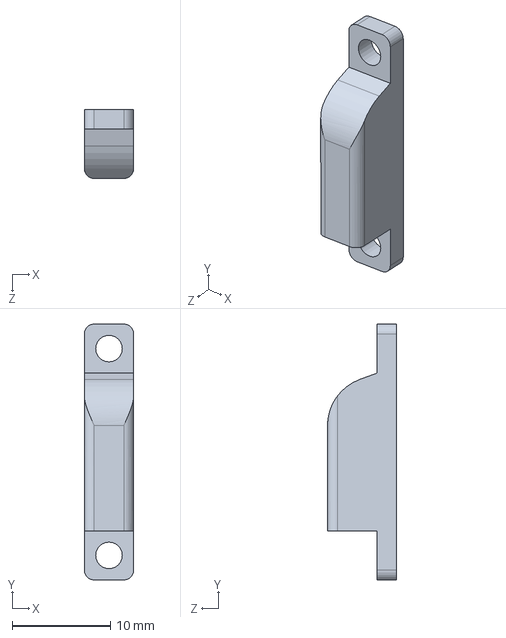
[picture p68: CAD file, 2019-06-18]
MOUTH/IR protector.SLDPRT
5.00 x 26.0 x 7.00 mm
