ZJUNlict/Mechanics/MOUTH/dribble motor.SLDPRT

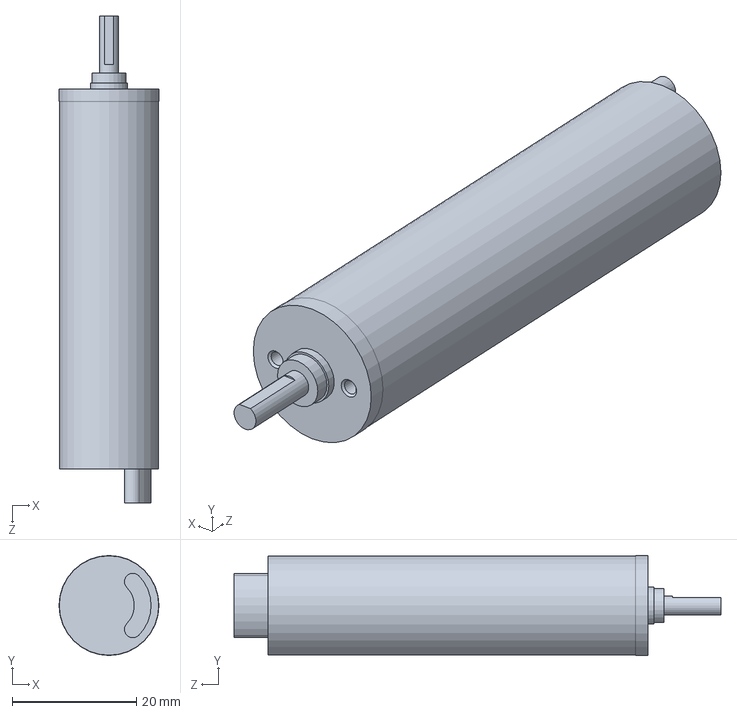
[picture p69: CAD file, 2019-06-18]
MOUTH/dribble motor.SLDPRT
16.1 x 16.1 x 78.4 mm
