ZJUNlict/Mechanics/MOUTH/dribble rod.SLDPRT

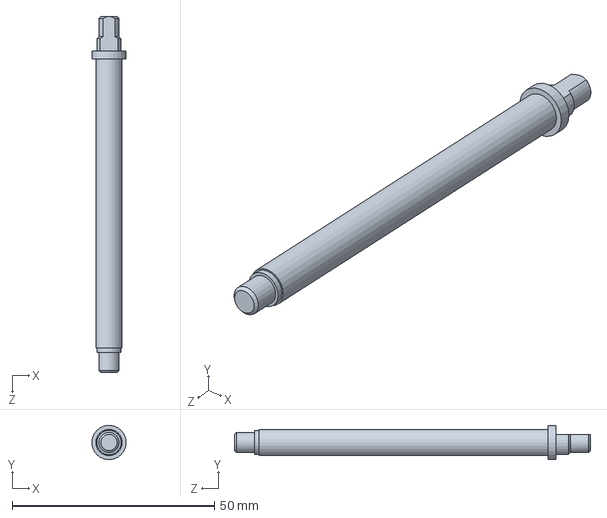
[picture p70: CAD file, 2019-06-18]
MOUTH/dribble rod.SLDPRT
8.50 x 8.50 x 88.0 mm
