ZJUNlict/Mechanics/MOUTH/IR constraint.SLDPRT

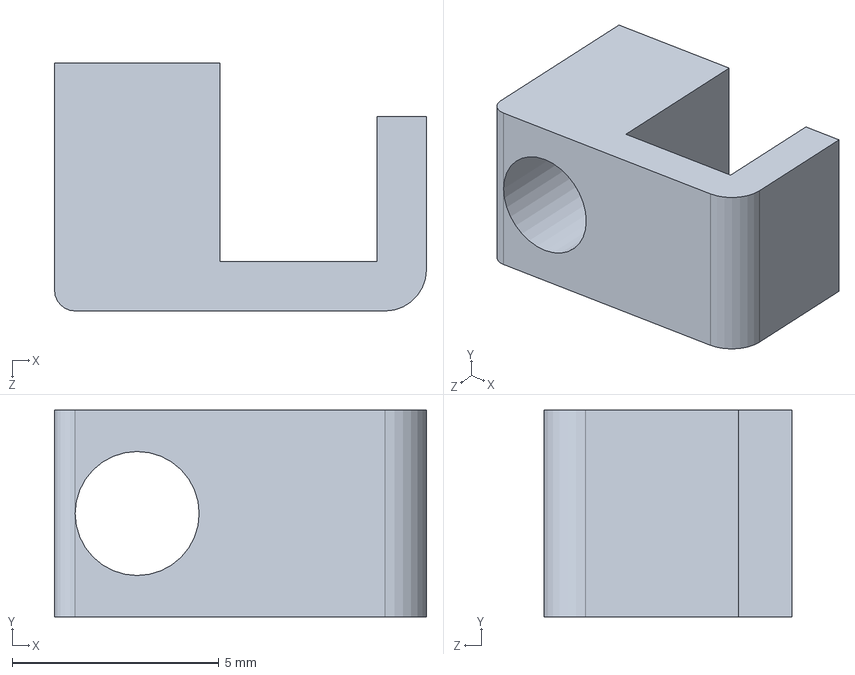
[picture p71: CAD file, 2019-06-18]
MOUTH/IR constraint.SLDPRT
9.00 x 5.00 x 6.00 mm
