ZJUNlict/Mechanics/MOUTH/motor sleeve.SLDPRT

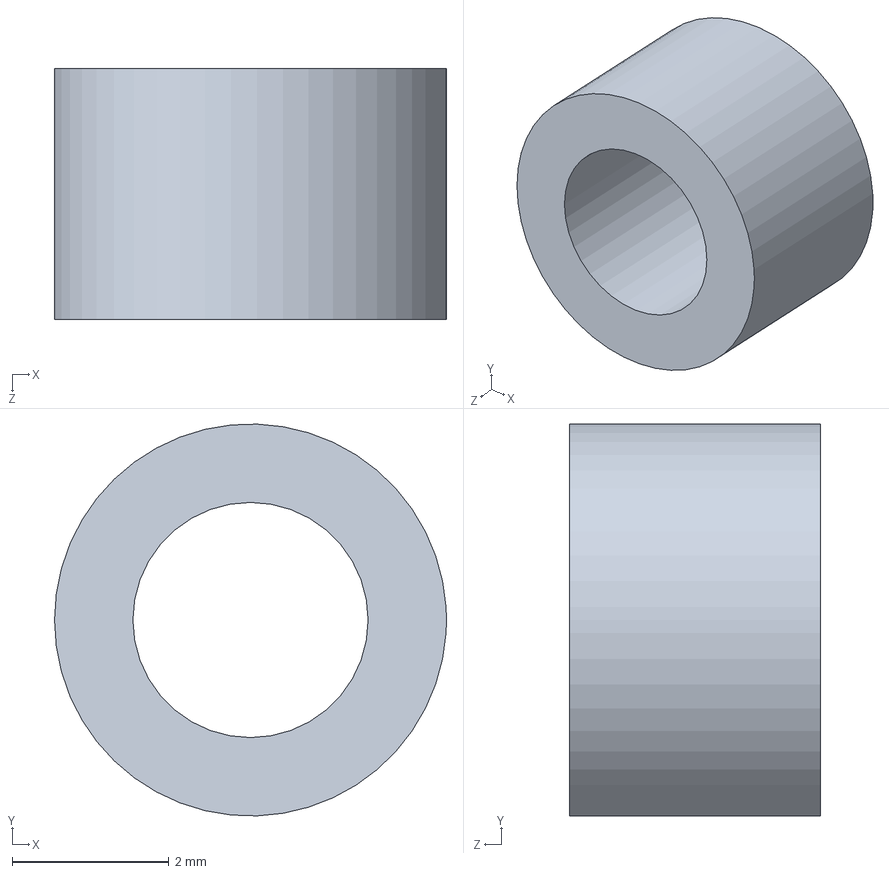
[picture p73: CAD file, 2019-06-18]
MOUTH/motor sleeve.SLDPRT
5.00 x 5.00 x 3.20 mm
