ZJUNlict/Mechanics/MOUTH/IR block1.SLDPRT

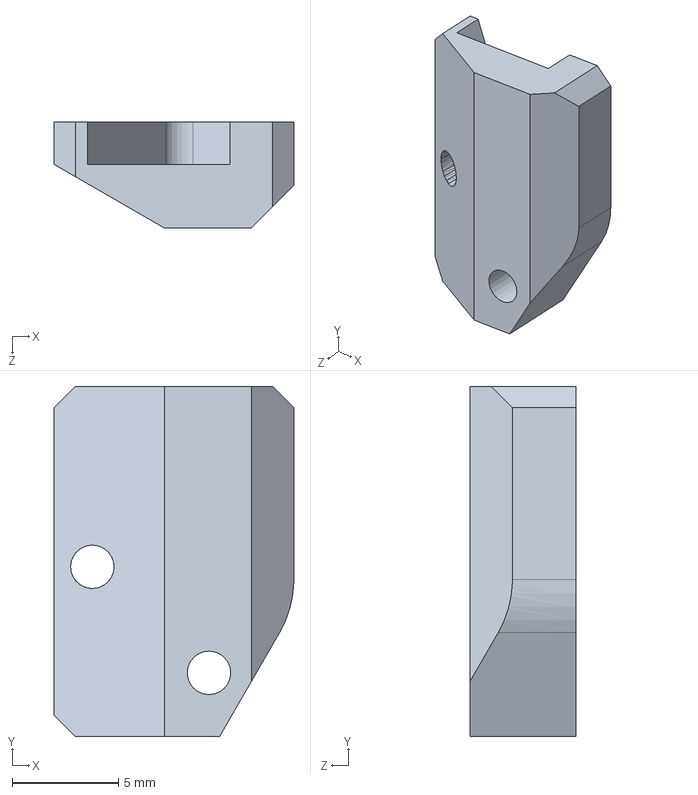
[picture p74: CAD file, 2019-06-18]
MOUTH/IR block1.SLDPRT
11.3 x 16.5 x 5.00 mm
