ZJUNlict/Mechanics/(list of files, cad)

Other CAD files:
MOUTH/dribble shelf_2.SLDPRT
MOUTH/_MR84ZZ Inner Ring.sldprt
MOUTH/_MR84ZZ Outer Ring.sldprt
KICK SYS/coil cylinder.SLDPRT
MOTOR/gearbox_1.SLDPRT
MOUTH/_MR84ZZ Shield2.sldprt
MOUTH/_MR84ZZ Ball.sldprt
MOUTH/_MR84ZZ Shield1.sldprt
MOUTH/flat guide block_1.SLDPRT
MOTOR/fastener/GB_CROSS_SCREWS_TYPE1 M3X6-6 H TYPE-N.sldprt
MOTOR/fastener/GB_CROSS_SCREWS_TYPE1 M4X6-6 H type-N.SLDPRT
MOTOR/fastener/GB_CROSS_SCREWS_TYPE1 M4X8-8 H type-N.SLDPRT
MOTOR/fastener/GB_CROSS_SCREWS_TYPE10 M2.5X5-3.5-H1-N.SLDPRT
MOTOR/fastener/GB_CROSS_SCREWS_TYPE10 M5X10-7.3-H1-N.SLDPRT
MOTOR/fastener/GB_CROSS_SCREWS_TYPE4 M1.6X8-7 H type-N.SLDPRT
MOTOR/fastener/GB_CROSS_SCREWS_TYPE4 M2X6-4.8 H type-N.SLDPRT
MOTOR/fastener/GB_CROSS_SCREWS_TYPE4 M3X6-4.35 H type-N.SLDPRT
MOTOR/fastener/GB_FASTENER_SCREWS_HSHCS M2.5X5-N.SLDPRT
MOTOR/fastener/GB_FASTENER_SCREWS_HSHCS M2.5X8-N.SLDPRT
MOTOR/fastener/GB_FASTENER_SCREWS_HSHCS M2X6-N.SLDPRT
MOTOR/fastener/GB_FASTENER_SCREWS_HSHCS M3X6-N-.SLDPRT
MOTOR/fastener/GB_FASTENER_SCREWS_HSHCS M4X8-N.SLDPRT
MOTOR/fastener/GB_FASTENER_WASHER_PWNA 4.SLDPRT
