ZJUNlict/Mechanics/(commit log)

2019-06-18 ZJUNlict Mechanical
    [50w_motor_1 assembly.SLDASM, 50w_motor_2 assembly.SLDASM, 698ZZ.SLDPRT, BASE.SLDASM, GB_CROSS_SCREWS_TYPE1 M3X6-6 H TYPE-N.sldprt, GB_CROSS_SCREWS_TYPE1 M4X6-6 H type-N.SLDPRT, GB_CROSS_SCREWS_TYPE1 M4X8-8 H type-N.SLDPRT, GB_CROSS_SCREWS_TYPE10 M2.5X5-3.5-H1-N.SLDPRT]
2019-06-18 2018 Version
    [chip shaft.SLDPRT, dribble shelf_1.SLDPRT, dribble shelf_2.SLDPRT, small wheel assembly.SLDASM, small wheel.SLDPRT, spring block_2.SLDPRT]
2019-06-19 update Maxon motor
